Sovol3d/SV06-PLUS/SV06 PLUS-Screen/DWIN_SET/065_C_PrintHeating.jpg

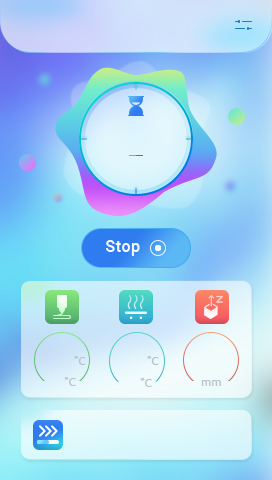
SV06 PLUS-Screen/DWIN_SET/065_C_PrintHeating.jpg
