Sovol3d/SV06-PLUS/SV06 PLUS-Screen/DWIN_SET/013_C_PrintConfirm.jpg

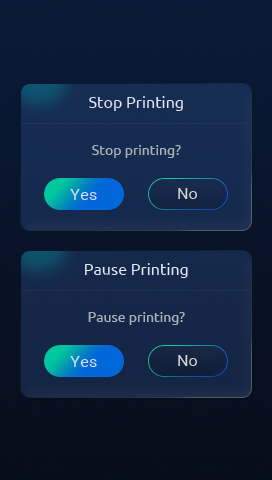
SV06 PLUS-Screen/DWIN_SET/013_C_PrintConfirm.jpg
