Sovol3d/SV06-PLUS/README.md

# Introduction

Sovol SV06 Plus 3d printer is the larger version of Sovol SV06 but with some new upgrades. Its large 300x300x340mm build volume meets all your 3D printing needs, also it comes with some new upgrade. It comes with a new sovol self-developed high flow all metal hotend, the bigger melt zone and traffic make it capable to print at 150mm/s as standard printing speed. Added touch screen, it looks more fashion and technical. Besides, it  has the 450 watt PSU, filament sensor, spinnable spool holder. Welcome to check more on sovol3d.com.
# Related tutorials 

- User Manual. [Click here](https://drive.google.com/file/d/1bJmc2MeOSmn5svG3CuQQvvp3vNMjcOrR/view)
- Sovol Tech Support Youtube Channel: https://www.youtube.com/@sovoltechsupport/videos 
# Learn more

on Sovol Official Website: https://sovol3d.com/products/sovol-sv06-plus

# Source code

This is the official source code for Sovol SV06 PLUS. The damage caused by modifying firmware also using the third party firmware will lose the 1 year warranty. If you need support, it’s recommended to reflash the stock firmware before contacting sovol.

Sovol doesn’t provide tech help for help users to modify source code, but if you need us to add more functions, you are welcome to send us your suggestions via Facebook Messenger or email 
info@sovol3d.com

# Join Sovol Community

- Sovol Facebook page: https://www.facebook.com/sovol3d/
- Sovol Youtube Channel: https://www.youtube.com/c/Sovol/videos
- Sovol Offcial User Group: https://www.facebook.com/groups/sovol3d
- Sovol Forum website: https://forum.sovol3d.com/
- Sovol SV06 PLUS & SV06 Official User Group: https://www.facebook.com/groups/sovolsv06usergroup
