Sovol3d/SV06-PLUS/SV06 PLUS Mechanical PDF/JXHSV06P-08001-g adapter board to motherboard cable.pdf

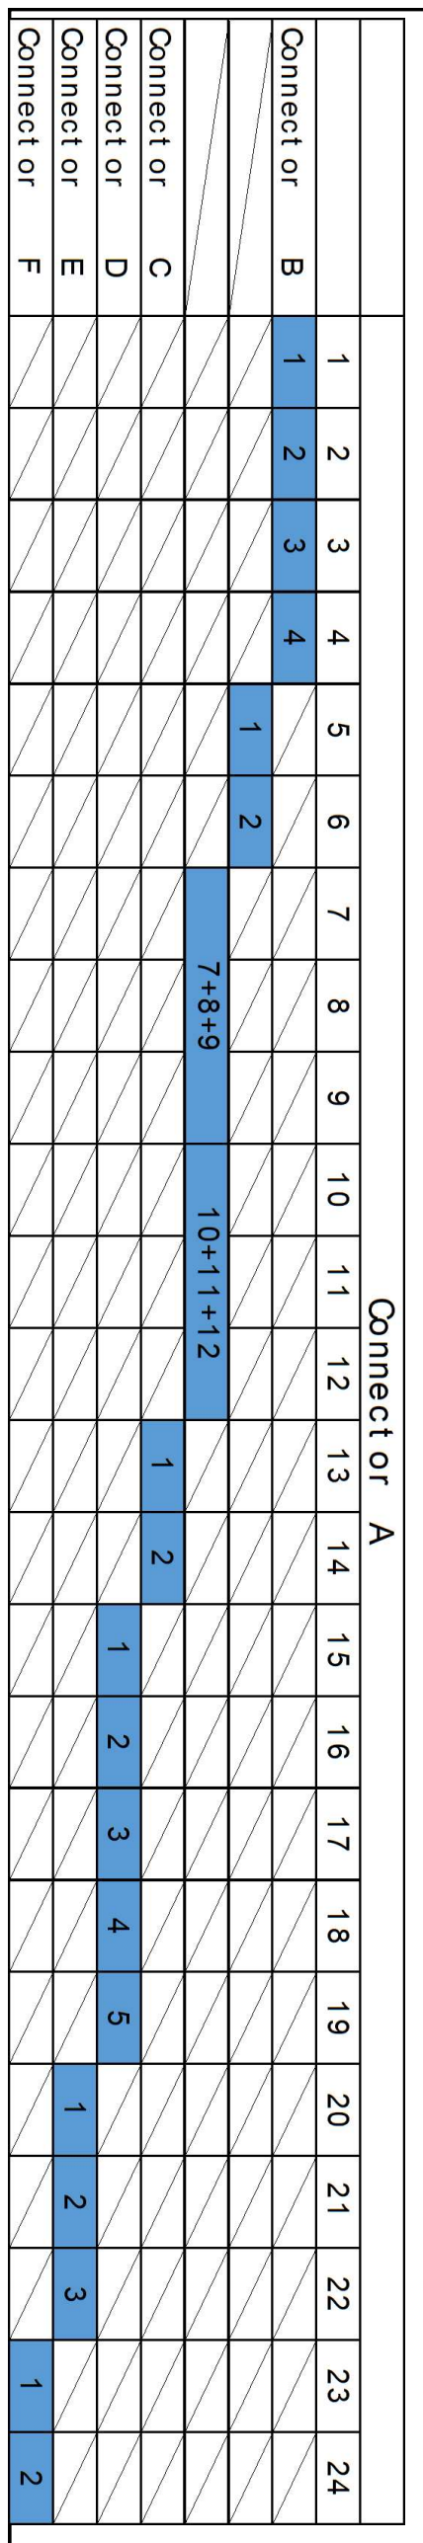
[picture p3: figure]

242 23 1 cable 26AWGCopperspacing1.0mmblack UL 1007 FC 24pin 2.0spacing black Connector A WWrapped with black acetate tape idth 30mm 100mm±10 length Tail tear Connector IIDEseven 640±10 740±10 41 woven mesh Wrapped in black 14 XH 2.54*4P Connector B Wire No. Tube Marking"E 1 3 XH2.54-3Pterminal Wire No. Tube Marking"DET Connector E 3 1 Wire No. Tube Marking"FAN-" terminals E0508 Crimp black tubular pre-insulated E0508 Crimp Red Tube Pre-Insulated terminal Wire No. Tube Marking"FAN+” Tube Marking"K-FAN" Connector CWire No. XH 2.54*5P Connector D 51 XH 2.54*2P Connector C 12 51 terminalsE0508 3Wire merging + crimping red tubular pre-insulated Tube+" Line No. Tube Mark "Heating pre-insulated terminalsE0508 3Wire merging + crimping black tubular Wire No. Tube Marking "Heating Tube-" 21 Wire No. Tube Marking"TH" XH 2.54*2P Connector F 21 21 Wiring diagram JXHSV06P-08001-g JXHSV06P Adapter-motherboard connection line Liu Ye Wrapped in black acetate (placed near the "E" end) Length 180mm width 10mm thickness 0.4mm Cable support plate tape width 30mm(This acetate tape will be Cable support plate fixed) WWrapped with black acetate tape udth 30mm 15 15 180

## 10 Version A0 Material Code

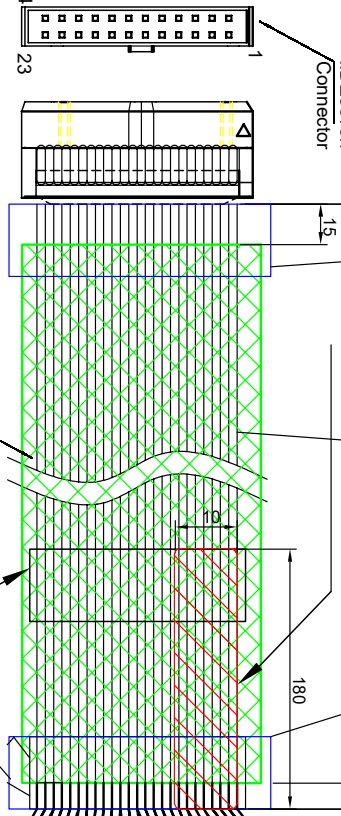
[picture p4: figure]
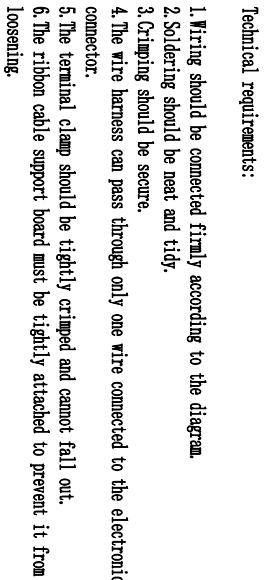
[picture p5: figure]
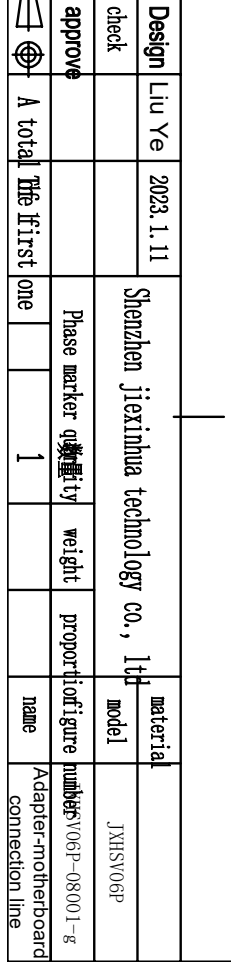
[picture p6: figure]
