Sovol3d/SV06-PLUS/SV06 PLUS Mechanical PDF/JXHSV06P-08002-g X axis cable.pdf

# serial describe model quantity 1

2

3
4

5 4PCS et mr ni al 6 X axis cable wire 1PCS case plastic terminal ptube number Line lastic case 1007 24AWG 4Pparallel black mark：X xxmm 4PCS 1PCS PH2.0-T PH2.0-6Y white XH2.54-T XH2.54-4Y 4x30 Ref 12 34 5 Tube"X Digital Tube"X" Digital jumpers 2,3 540±5mm 61 41 Aend Bend Aend Bend 1 32 634 1 wire sheet 4 XH2.54-4Yterminal Liu Ye 2022/12/9 JXHSV06P JXHSV06P-08002-g Version A0 Material coding

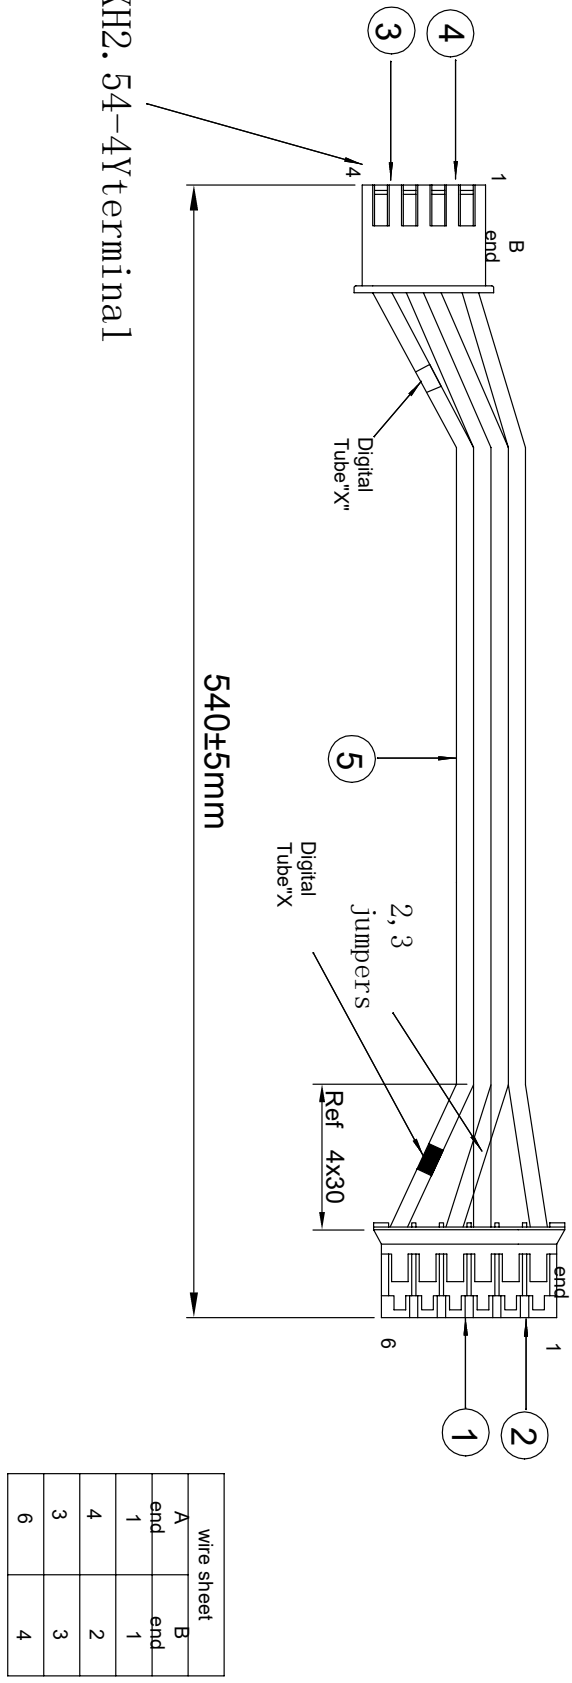
[picture p7: figure]
