Sovol3d/SV06-PLUS/SV06 PLUS Mechanical PDF/JXHSV06P-08017-g YZ axis cable（1）.pdf

# serial description model quantity 1

2

3
4

5 4PCS et mr ni all 6 JXHSV06P wire 1PCS nLine umber ettubemr ni all case plastic p al st ci cover 1007 24AWG 4P parallel black marker：Y xxmm 4PCS 1PCS PH2.0-T PH2.0-6Y white XH2.54-T XH2.54-4Y 4x30 Ref 12 34 5 2,3jumpers 480±5mm 61 41 A end B end A end B end 1 32 634 1 wiring table 4 Terminal XH2.54-4Y nixie tube mark "Y This end sets the mark "Y nixie tube sets the This end terminal PH2.0-6Y JXHSV06P-08017-g version A0 number Material
