Sovol3d/SV06-PLUS/SV06 PLUS Mechanical PDF/JXHSV06P-08017-g YZ axis cable（2）.pdf

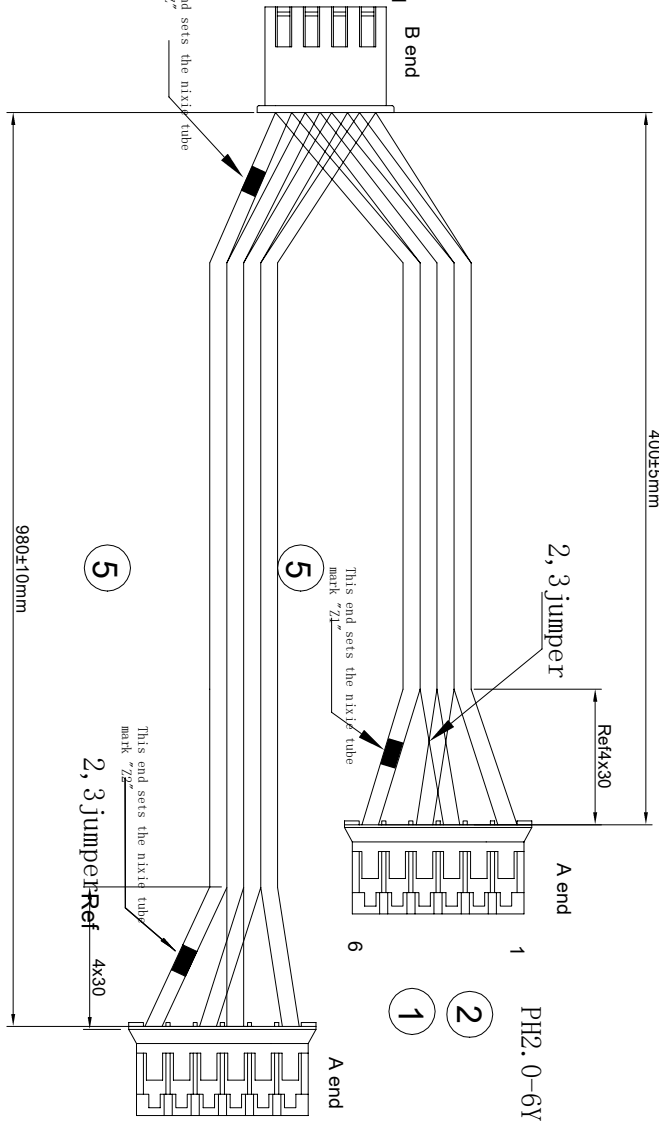
[picture p8: figure]
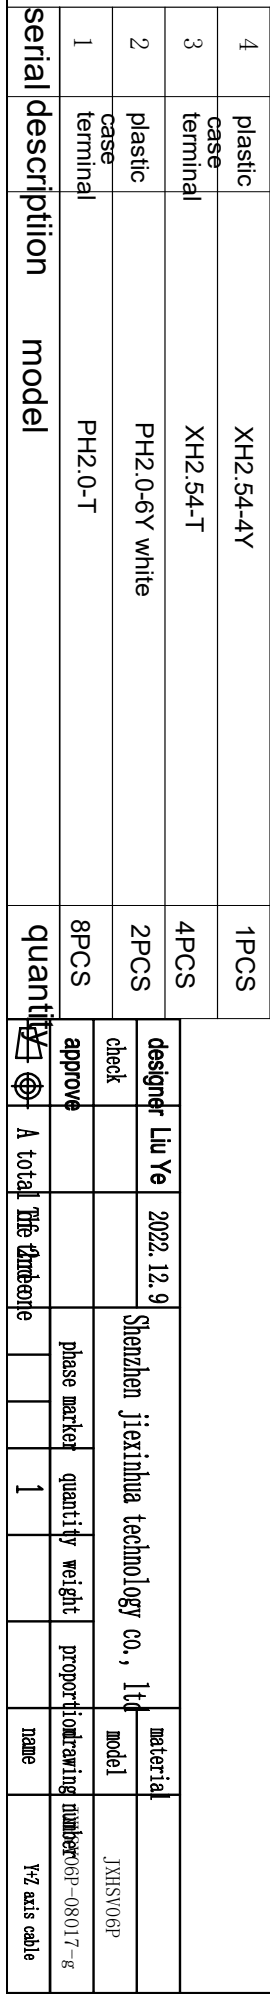
[picture p9: figure]
serial descriptiion model quantity 1

5 8PCS et mr ni al 6 JXHSV06P wire 2PCS ettube number wire mr ni al case plastic p al st ci case 1007 24AWG 4Pparaller black marker：Z，Z1，Z2 xxmm 4PCS 1PCS PH2.0-T PH2.0-6Y white XH2.54-T XH2.54-4Y 4x30 Ref 12 34 5 2,3jumper 61 41 A end B end A end B end 1 32 634 1 wiring table 4 terminal

XH2.54-4Y 5 61 2,3jumper Ref4x30 A end 980±10mm 400±5mm mark "Z" This end sets the nixie tube mark "Z1" This end sets the nixie tube PH2.0-6Y terminal PH2.0-6Y terminal mark "Z2" This end sets the nixie tube 12 JXHSV06P-08017-g version A0 number material
