Sovol3d/SV06-PLUS/SV06 PLUS Mechanical PDF/JXHSV06P-08017-g YZ axis cable（3）.pdf

2 B endB end A end Aend A end Yaxis cable Z axis cable black acetate glue 1 black acetate tape serial description model quantity 123456 JXHSV06P 1PCS Combine Ymotor wire,ZTwo-in-one motor cable wire wire 1PCS Y axis wire z ax si wire JXHSV06P-08017-g Version A0 material code 15±5mm 15±5mm 15±5mm 15±5mm 90±10mm

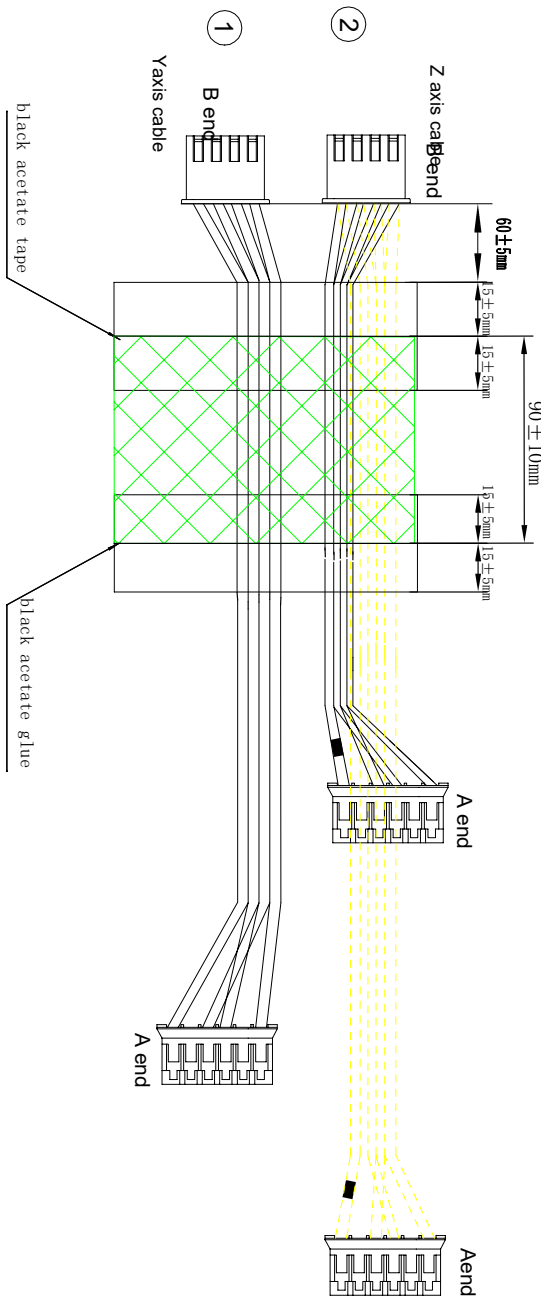
[picture p10: figure]
