Sovol3d/SV06-PLUS/SV06 PLUS Mechanical PDF/JXHSV06P-08022-g power cable( connect to mainboard).pdf

# serial description model quantity 1

2

3

### 4 plug MT60 M- (ma el ) tube digital mark：POWER 1 2 Marking"POWER

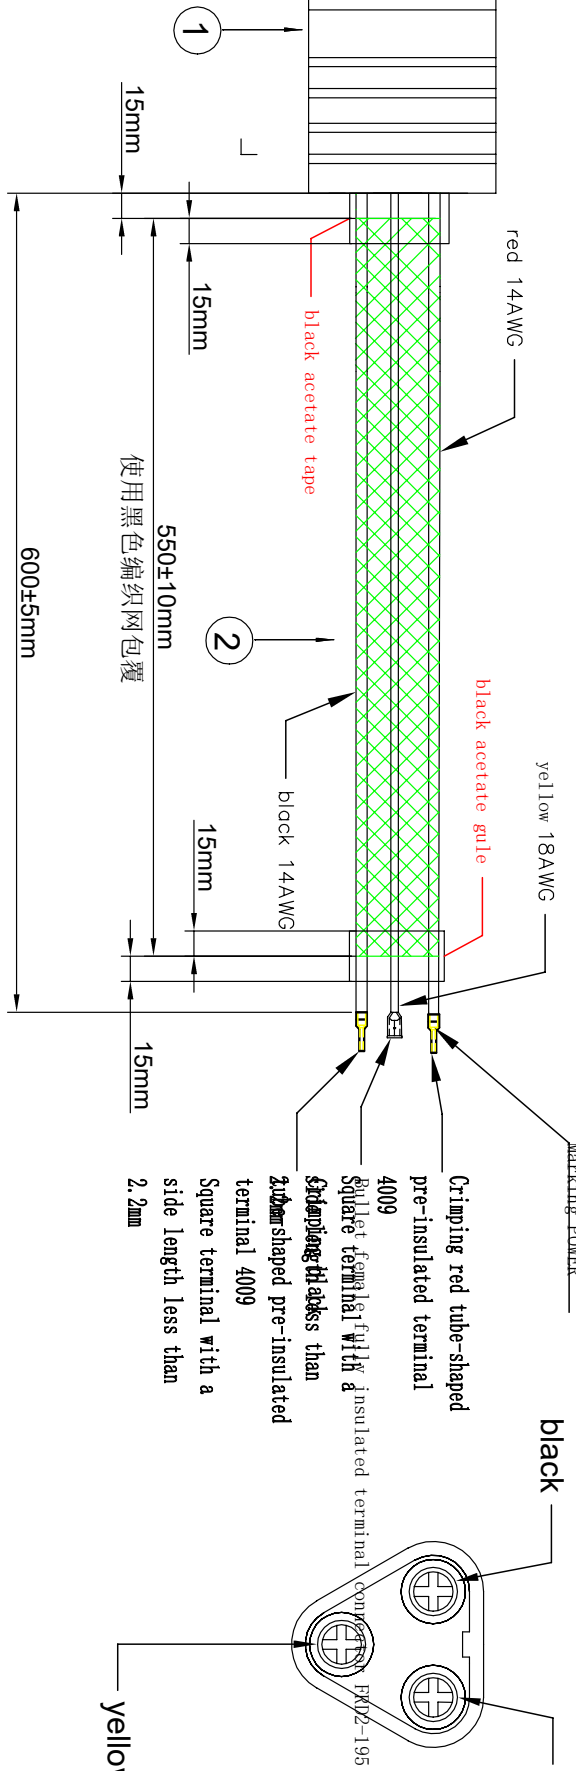
[picture p11: figure]
yellow

## Wire No. Tube

使用黑色编织网包覆 wire 14AWG red and b al ck wire Bullet female fully insulated terminal connector FRD2-195 blue

black acetate tape 550±10mm 15mm 600±5mm black acetate gule version A0 material code wire 18AWGyel ol w wire REV. DATE REVISION ORIGINOR SIGN ISSUED 2023.3.17 18AWG connect to the ground wire to Enda Wang 15mm 15mm 15mm yellow black red
