Sovol3d/SV06-PLUS/SV06 PLUS Mechanical PDF/JXHSV06P-08023-g filament runout sensor(connect to detect device).pdf

approve check design a total of one first The name 比例 weight quantity phase marker drawing number model material 1 co., ltd Shenzhen jiexinhua technology C2502-H03 black terminal XH2.54-3P 700±10mm filament runout sensor (connected the detection device) number serial description model quantity 123456 wire xxmm JXHSV06P-08023-g JXHSV06P 1007 24AWG black three black lines version A0 material code Liu Ye

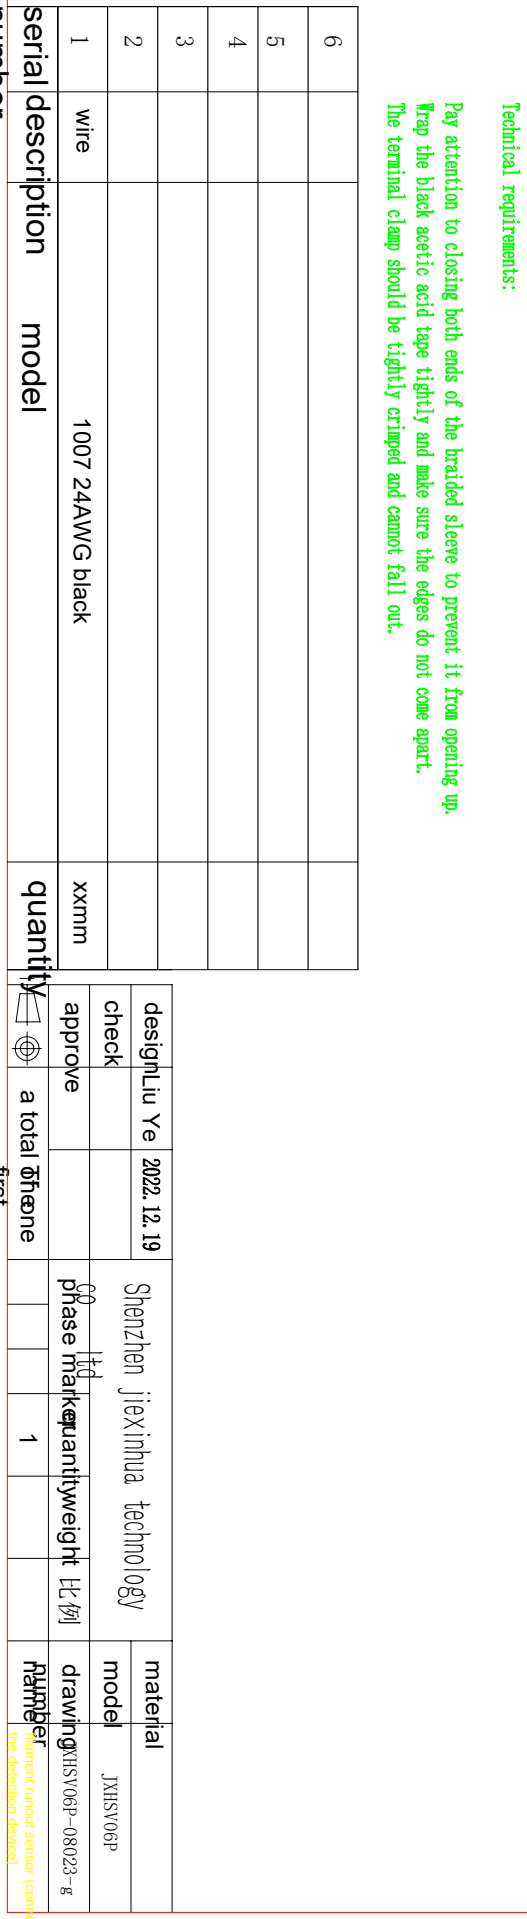
[picture p12: figure]
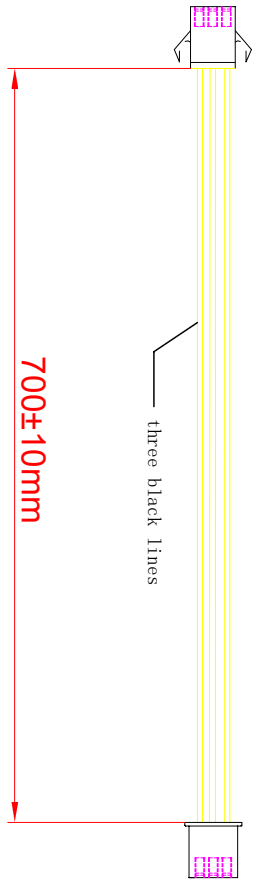
[picture p13: figure]
