Sovol3d/SV06-PLUS/SV06 PLUS Mechanical PDF/JXHSV06P-08024-g filament runout sensor（connect to mainboard）.pdf

approve check design a total o fone first The name proportion weight quantity phase marker drawing number model material 1 co., ltd Shenzhen jiexinhua technology filament runout sensor (connected the motherboard) Liu Ye C2501-H03 buckle XH2.54-3Pterminal 220±5mm number serial description model quantity 123456 wire This end sets the nixie tube mark "DET JXHSV06P JXHSV06P-08024-g 1007 24AWG black 3 black wire aligned version A0 material code

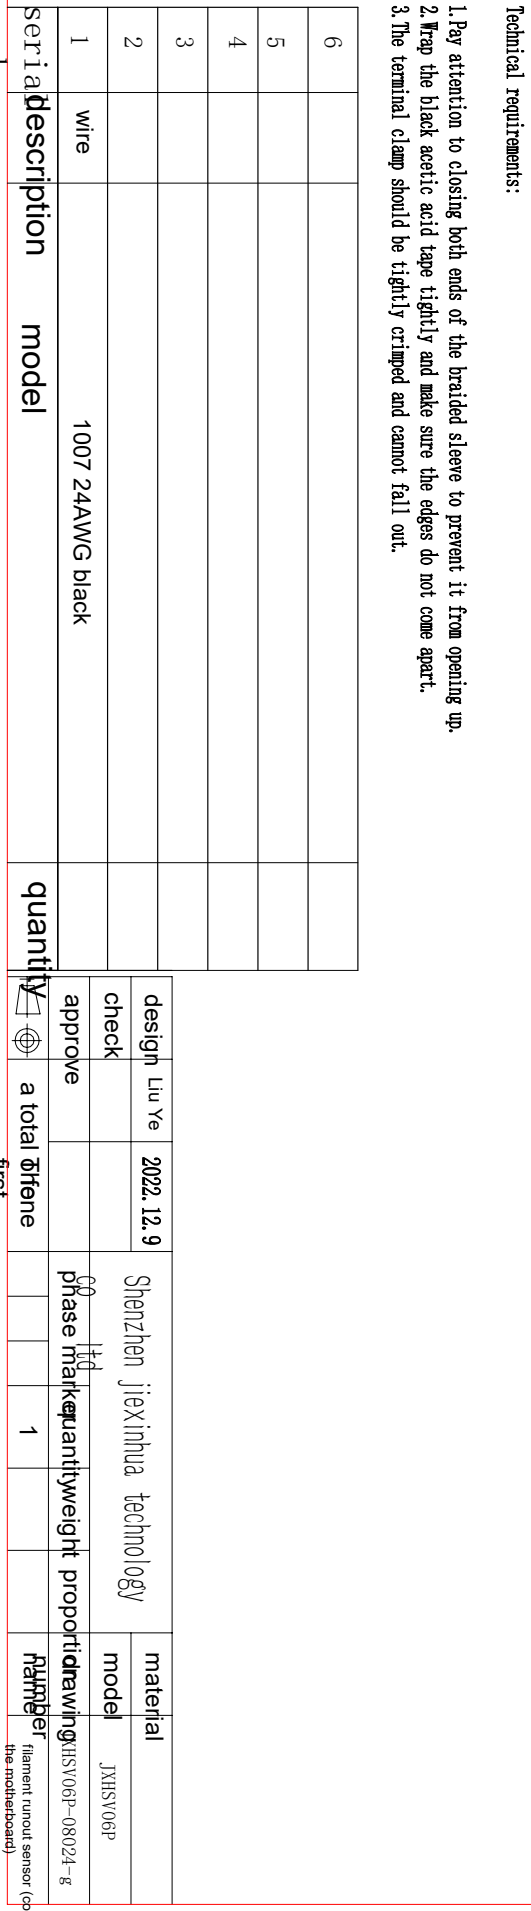
[picture p14: figure]
