Sovol3d/SV06-PLUS/SV06 PLUS-Screen/32_main/000_starting.jpg

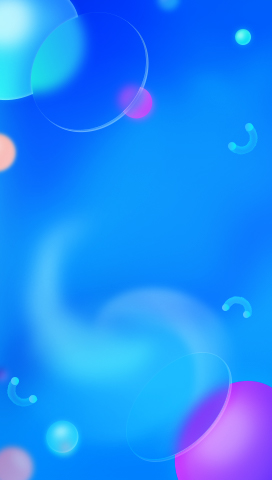
SV06 PLUS-Screen/32_main/000_starting.jpg
