Sovol3d/SV06-PLUS/SV06 PLUS-Screen/32_main/007_C_FilamentChange.jpg

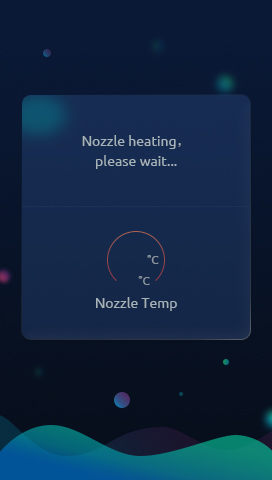
SV06 PLUS-Screen/32_main/007_C_FilamentChange.jpg
