Sovol3d/SV06-PLUS/SV06 PLUS-Screen/32_main/015_C_TempControl.jpg

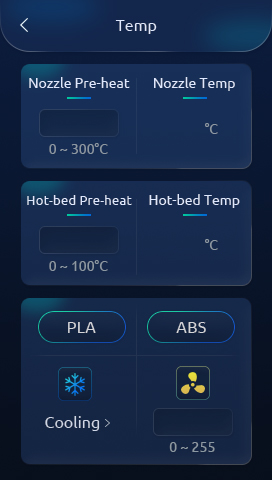
SV06 PLUS-Screen/32_main/015_C_TempControl.jpg
