Sovol3d/SV06-PLUS/SV06 PLUS-Screen/32_main/019_C_ControlConfirm.jpg

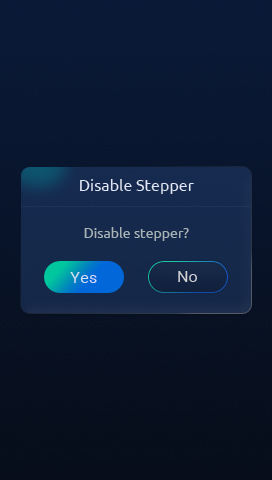
SV06 PLUS-Screen/32_main/019_C_ControlConfirm.jpg
