Sovol3d/SV06-PLUS/SV06 PLUS-Screen/32_main/022_C_BedLeveling.jpg

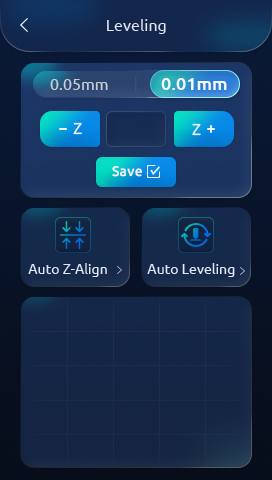
SV06 PLUS-Screen/32_main/022_C_BedLeveling.jpg
