Sovol3d/SV06-PLUS/SV06 PLUS-Screen/32_main/023_C_ChangeFilement.jpg

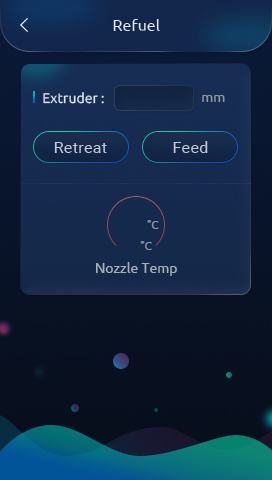
SV06 PLUS-Screen/32_main/023_C_ChangeFilement.jpg
