Sovol3d/SV06-PLUS/SV06 PLUS-Screen/32_main/027_C_CancelChange.jpg

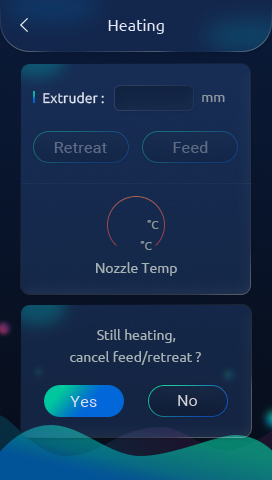
SV06 PLUS-Screen/32_main/027_C_CancelChange.jpg
