Sovol3d/SV06-PLUS/SV06 PLUS-Screen/32_main/031_C_01mmMove.jpg

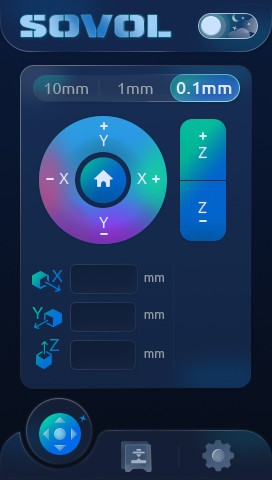
SV06 PLUS-Screen/32_main/031_C_01mmMove.jpg
