Sovol3d/SV06-PLUS/SV06 PLUS-Screen/32_main/032_C_Autohome.jpg

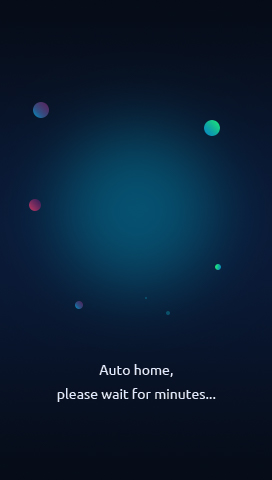
SV06 PLUS-Screen/32_main/032_C_Autohome.jpg
