Sovol3d/SV06-PLUS/SV06 PLUS-Screen/32_main/042_C_CoolDown.jpg

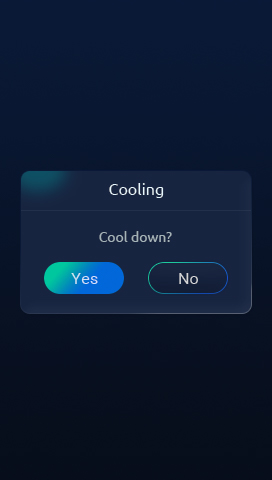
SV06 PLUS-Screen/32_main/042_C_CoolDown.jpg
