Sovol3d/SV06-PLUS/SV06 PLUS-Screen/32_main/048_C_InitConfirm.jpg

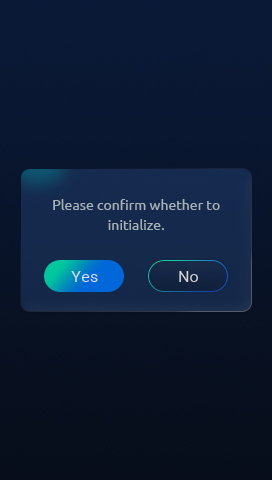
SV06 PLUS-Screen/32_main/048_C_InitConfirm.jpg
