Sovol3d/SV06-PLUS/SV06 PLUS-Screen/32_main/051_KeyboardPush.jpg

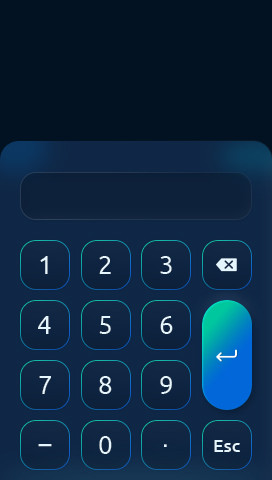
SV06 PLUS-Screen/32_main/051_KeyboardPush.jpg
