Sovol3d/SV06-PLUS/SV06 PLUS-Screen/32_main/053_heatingfailed.jpg

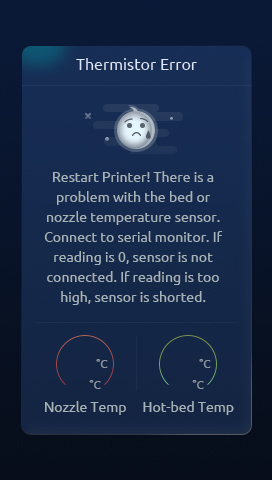
SV06 PLUS-Screen/32_main/053_heatingfailed.jpg
