Sovol3d/SV06-PLUS/SV06 PLUS-Screen/32_main/063_C_FilamentResume.jpg

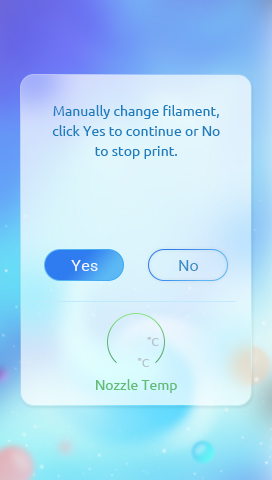
SV06 PLUS-Screen/32_main/063_C_FilamentResume.jpg
