Sovol3d/SV06-PLUS/SV06 PLUS-Screen/32_main/069_C_Ajustment.jpg

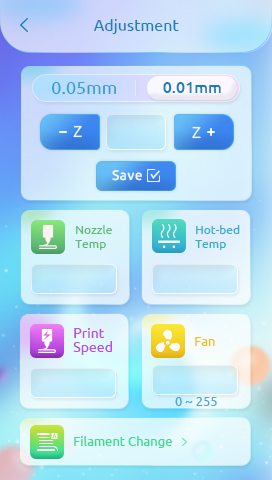
SV06 PLUS-Screen/32_main/069_C_Ajustment.jpg
