Sovol3d/SV06-PLUS/SV06 PLUS-Screen/32_main/075_C_NoFilament.jpg

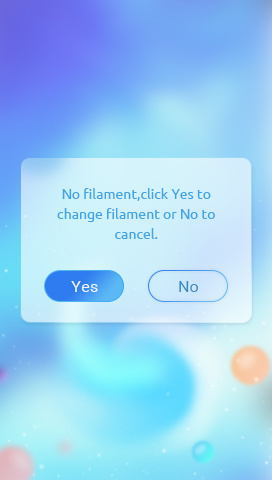
SV06 PLUS-Screen/32_main/075_C_NoFilament.jpg
