Sovol3d/SV06-PLUS/SV06 PLUS-Screen/32_main/076_C_Tool.jpg

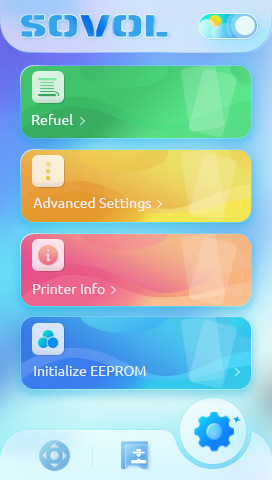
SV06 PLUS-Screen/32_main/076_C_Tool.jpg
