Sovol3d/SV06-PLUS/SV06 PLUS-Screen/32_main/079_C_Warn1.jpg

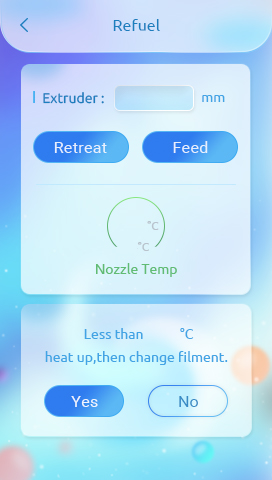
SV06 PLUS-Screen/32_main/079_C_Warn1.jpg
