Sovol3d/SV06-PLUS/SV06 PLUS-Screen/32_main/080_C_Vetocity.jpg

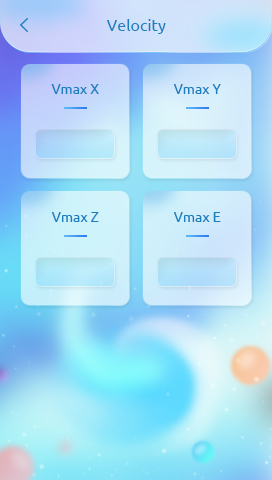
SV06 PLUS-Screen/32_main/080_C_Vetocity.jpg
