Sovol3d/SV06-PLUS/SV06 PLUS-Screen/32_main/085_C_1mmMove.jpg

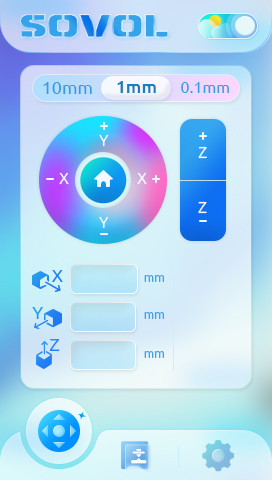
SV06 PLUS-Screen/32_main/085_C_1mmMove.jpg
