Sovol3d/SV06-PLUS/SV06 PLUS-Screen/32_main/089_C_Acceleration.jpg

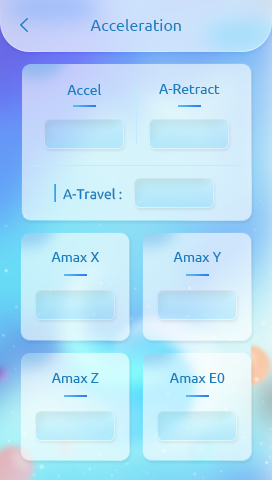
SV06 PLUS-Screen/32_main/089_C_Acceleration.jpg
