Sovol3d/SV06-PLUS/SV06 PLUS-Screen/32_main/104_AdvancedSetting.jpg

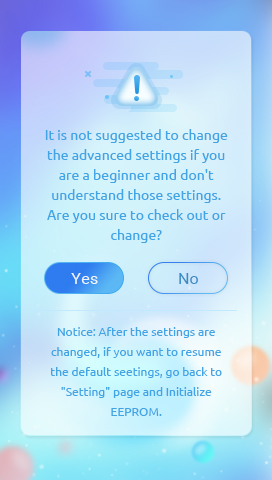
SV06 PLUS-Screen/32_main/104_AdvancedSetting.jpg
