Sovol3d/SV06-PLUS/SV06 PLUS-Screen/32_main/105_Keyboard.jpg

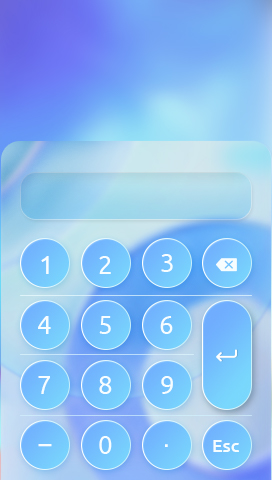
SV06 PLUS-Screen/32_main/105_Keyboard.jpg
