Sovol3d/SV06-PLUS/SV06 PLUS-Screen/32_main/108_heatingfailed.jpg

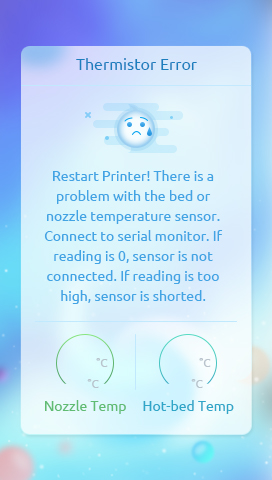
SV06 PLUS-Screen/32_main/108_heatingfailed.jpg
