Sovol3d/SV06-PLUS/SV06 PLUS-Screen/32_main/113_TMC Drivers.jpg

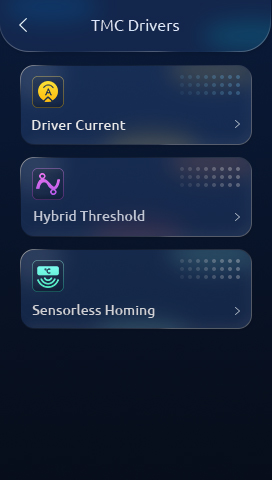
SV06 PLUS-Screen/32_main/113_TMC Drivers.jpg
