Sovol3d/SV06-PLUS/SV06 PLUS-Screen/32_main/114_Driver Current.jpg

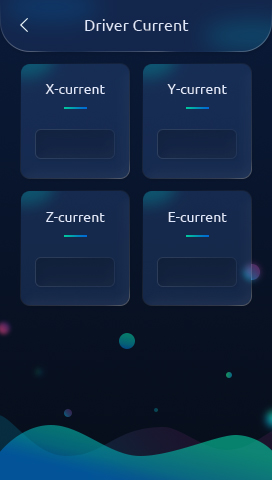
SV06 PLUS-Screen/32_main/114_Driver Current.jpg
