Sovol3d/SV06-PLUS/SV06 PLUS-Screen/32_main/116_Sensorless Homing.jpg

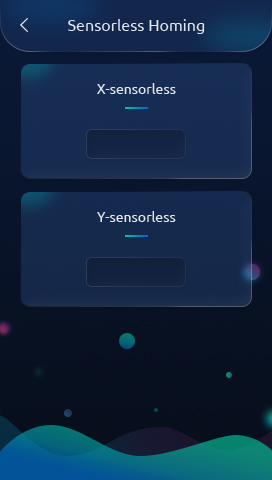
SV06 PLUS-Screen/32_main/116_Sensorless Homing.jpg
