Sovol3d/SV06-PLUS/SV06 PLUS-Screen/32_main/124_C_Wait.jpg

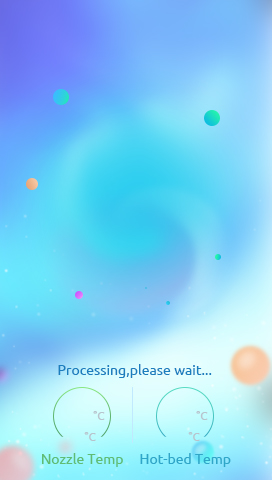
SV06 PLUS-Screen/32_main/124_C_Wait.jpg
