Sovol3d/SV06-PLUS/SV06 PLUS-Screen/47_time/3.jpg

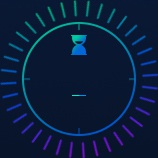
SV06 PLUS-Screen/47_time/3.jpg
