Sovol3d/SV06-PLUS/SV06 PLUS-Screen/49_rleve/3.jpg

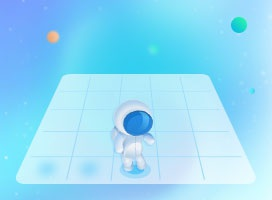
SV06 PLUS-Screen/49_rleve/3.jpg
