Sovol3d/SV06-PLUS/SV06 PLUS-Screen/49_rleve/4.jpg

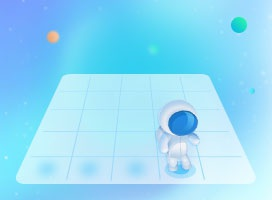
SV06 PLUS-Screen/49_rleve/4.jpg
