Sovol3d/SV06-PLUS/SV06 PLUS-Screen/50_bleve/5.jpg

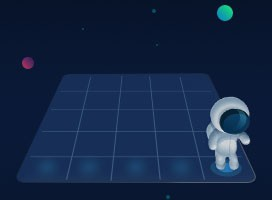
SV06 PLUS-Screen/50_bleve/5.jpg
