Sovol3d/SV06-PLUS/SV06 PLUS-Screen/52_rwait/7.jpg

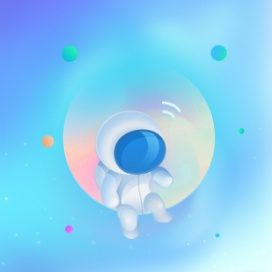
SV06 PLUS-Screen/52_rwait/7.jpg
