Sovol3d/SV06-PLUS/SV06 PLUS-Screen/54_bwait/15.jpg

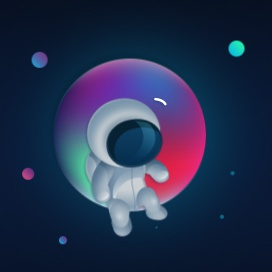
SV06 PLUS-Screen/54_bwait/15.jpg
