Sovol3d/SV06-PLUS/SV06 PLUS-Screen/58_rtime/3.jpg

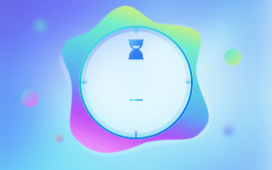
SV06 PLUS-Screen/58_rtime/3.jpg
