Sovol3d/SV06-PLUS/SV06 PLUS-Screen/58_rtime/7.jpg

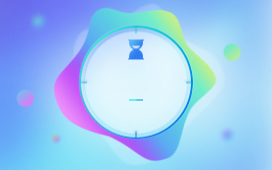
SV06 PLUS-Screen/58_rtime/7.jpg
