Sovol3d/SV06-PLUS/SV06 PLUS-Screen/58_rtime/17.jpg

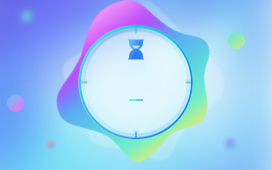
SV06 PLUS-Screen/58_rtime/17.jpg
