Sovol3d/SV06-PLUS/SV06 PLUS-Screen/DWIN_SET/001_C_main.jpg

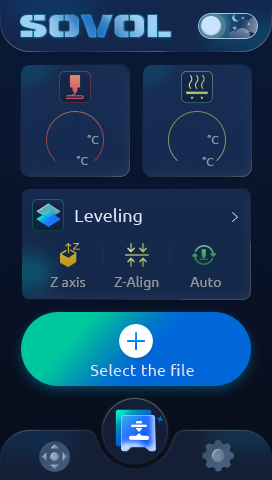
SV06 PLUS-Screen/DWIN_SET/001_C_main.jpg
