Sovol3d/SV06-PLUS/SV06 PLUS-Screen/DWIN_SET/014_C_Ajustment.jpg

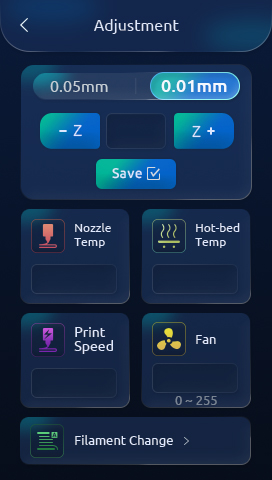
SV06 PLUS-Screen/DWIN_SET/014_C_Ajustment.jpg
