Sovol3d/SV06-PLUS/SV06 PLUS-Screen/DWIN_SET/035_C_Jerk.jpg

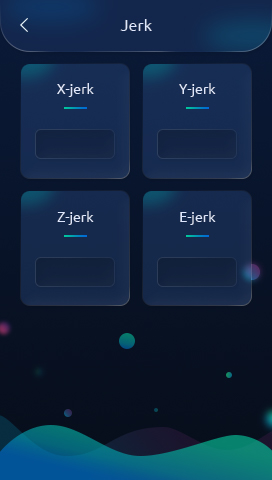
SV06 PLUS-Screen/DWIN_SET/035_C_Jerk.jpg
