Sovol3d/SV06-PLUS/SV06 PLUS-Screen/DWIN_SET/039_C_HeatStop.jpg

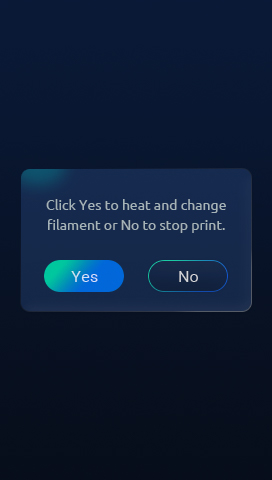
SV06 PLUS-Screen/DWIN_SET/039_C_HeatStop.jpg
