Sovol3d/SV06-PLUS/SV06 PLUS-Screen/DWIN_SET/041_C_TempPID.jpg

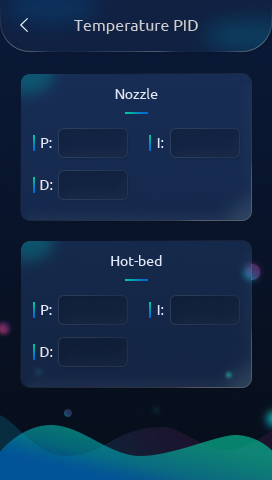
SV06 PLUS-Screen/DWIN_SET/041_C_TempPID.jpg
