Sovol3d/SV06-PLUS/SV06 PLUS-Screen/DWIN_SET/052_thermal_runaway.jpg

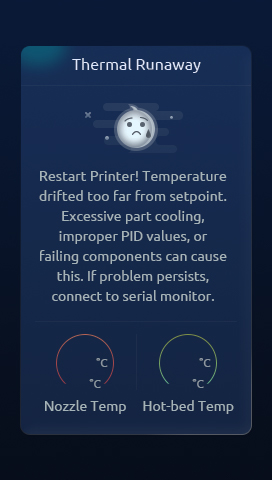
SV06 PLUS-Screen/DWIN_SET/052_thermal_runaway.jpg
