Sovol3d/SV06-PLUS/SV06 PLUS-Screen/DWIN_SET/055_Autohomefailed.jpg

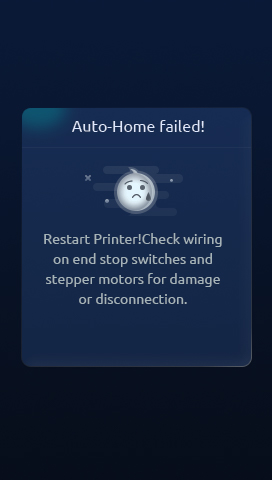
SV06 PLUS-Screen/DWIN_SET/055_Autohomefailed.jpg
