Sovol3d/SV06-PLUS/SV06 PLUS-Screen/DWIN_SET/070_C_TempControl.jpg

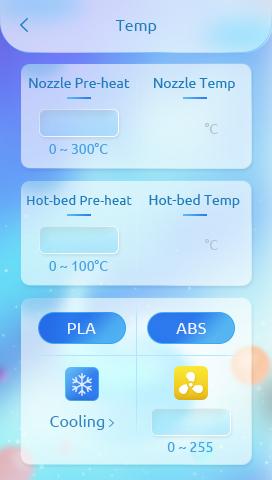
SV06 PLUS-Screen/DWIN_SET/070_C_TempControl.jpg
