Sovol3d/SV06-PLUS/SV06 PLUS-Screen/DWIN_SET/077_C_BedLeveling.jpg

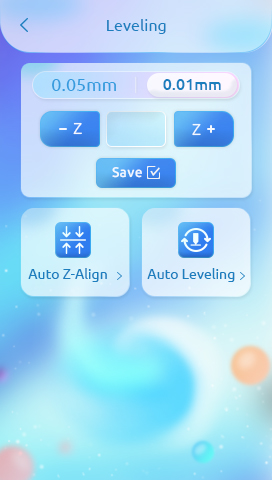
SV06 PLUS-Screen/DWIN_SET/077_C_BedLeveling.jpg
