Sovol3d/SV06-PLUS/SV06 PLUS-Screen/DWIN_SET/087_C_Autohome.jpg

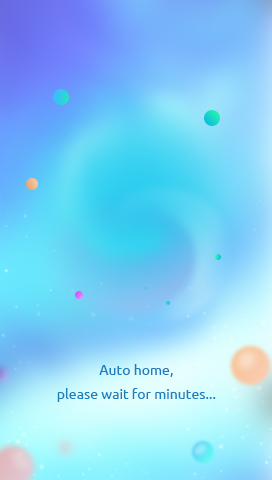
SV06 PLUS-Screen/DWIN_SET/087_C_Autohome.jpg
