Sovol3d/SV06-PLUS/SV06 PLUS-Screen/DWIN_SET/088_C_Information.jpg

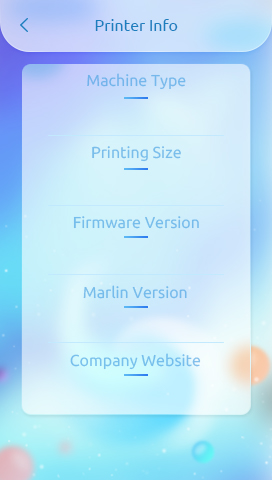
SV06 PLUS-Screen/DWIN_SET/088_C_Information.jpg
