Sovol3d/SV06-PLUS/SV06 PLUS-Screen/DWIN_SET/093_C_Autoleve.jpg

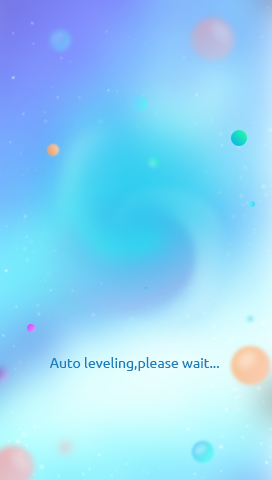
SV06 PLUS-Screen/DWIN_SET/093_C_Autoleve.jpg
