Sovol3d/SV06-PLUS/SV06 PLUS-Screen/DWIN_SET/106_KeyboardPush.jpg

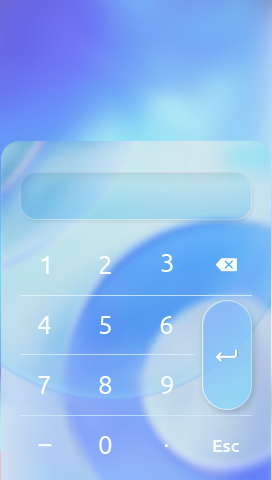
SV06 PLUS-Screen/DWIN_SET/106_KeyboardPush.jpg
