Sovol3d/SV06-PLUS/SV06 PLUS-Screen/DWIN_SET/112_Driver_error.jpg

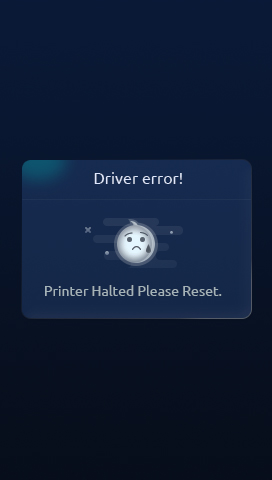
SV06 PLUS-Screen/DWIN_SET/112_Driver_error.jpg
