Sovol3d/SV06-PLUS/SV06 PLUS-Screen/DWIN_SET/119_TMC Drivers.jpg

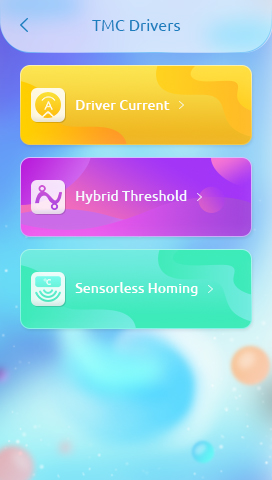
SV06 PLUS-Screen/DWIN_SET/119_TMC Drivers.jpg
