Sovol3d/SV06-PLUS/SV06 PLUS-Screen/DWIN_SET/122_Sensorless Homing.jpg

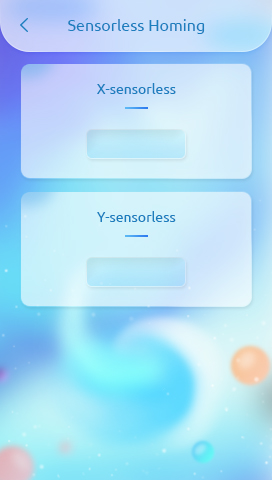
SV06 PLUS-Screen/DWIN_SET/122_Sensorless Homing.jpg
