Sovol3d/SV06-PLUS/SV06 PLUS 3D/STEP/JXHSV06P-01000 base assembly/JXHSV06-01019-d Wire Clip.step

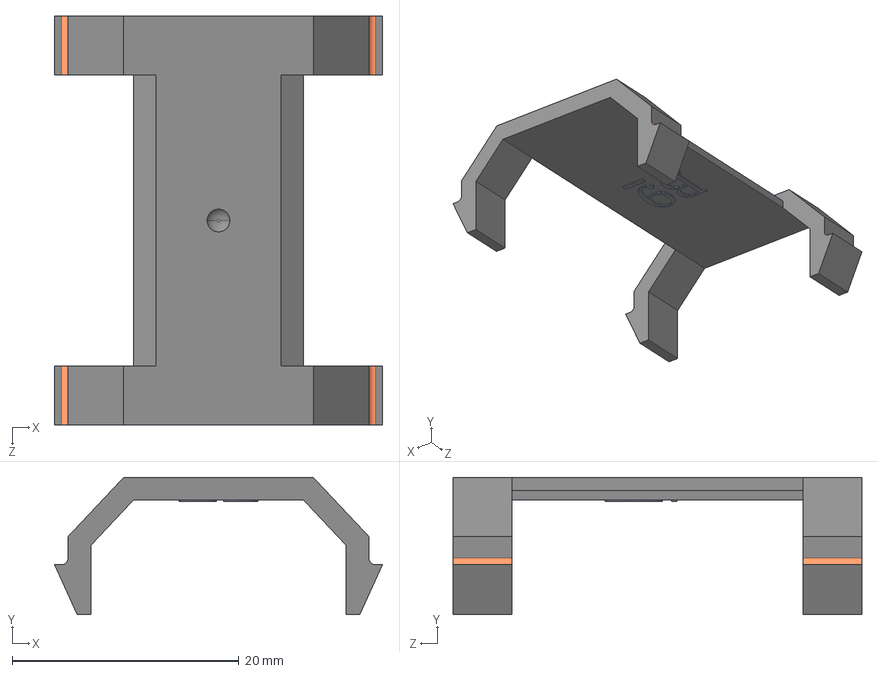
[picture p114: CAD file, 2023-06-09]
SV06 PLUS 3D/STEP/JXHSV06P-01000 base assembly/JXHSV06-01019-d Wire Clip.step
28.9 x 12.1 x 36.0 mm
