Sovol3d/SV06-PLUS/SV06 PLUS 3D/STEP/JXHSV06P-02000 gantry component/JXHSV06P-02007-d Z-axis right guide rod fixing block.step

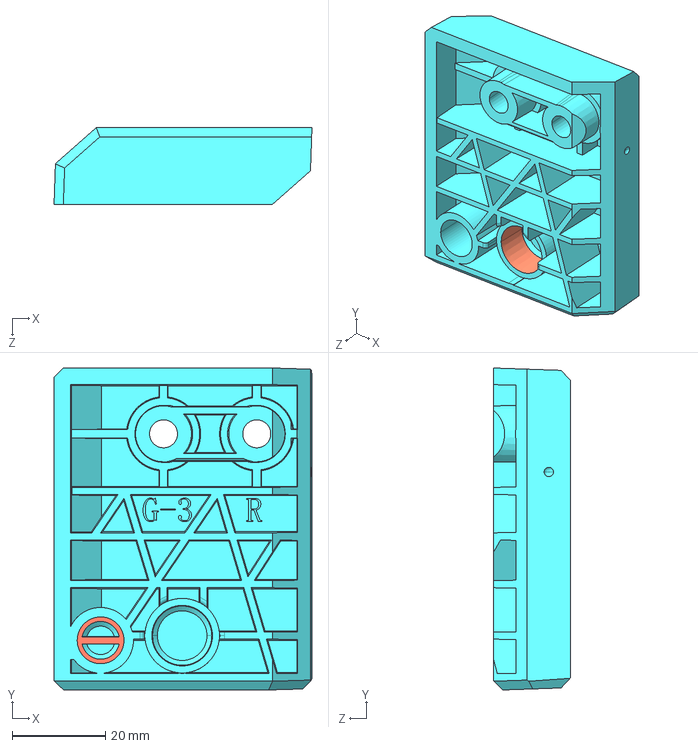
[picture p115: CAD file, 2023-06-09]
SV06 PLUS 3D/STEP/JXHSV06P-02000 gantry component/JXHSV06P-02007-d Z-axis right guide rod fixing block.step
55.3 x 69.1 x 16.5 mm
