Sovol3d/SV06-PLUS/SV06 PLUS 3D/STEP/JXHSV06P-03000 X-axis component/JXHSV06-03005-d X-axis tensioning wheel mounting seat.step

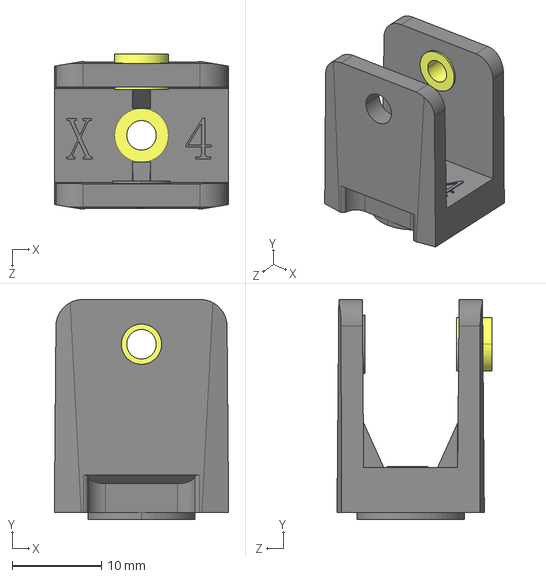
[picture p116: CAD file, 2023-06-09]
SV06 PLUS 3D/STEP/JXHSV06P-03000 X-axis component/JXHSV06-03005-d X-axis tensioning wheel mounting seat.step
19.5 x 24.6 x 17.3 mm
