Sovol3d/SV06-PLUS/SV06 PLUS 3D/STEP/JXHSV06P-04000 motherboard box component/JXHSV06-04003-d motherboard box lower hinge.step

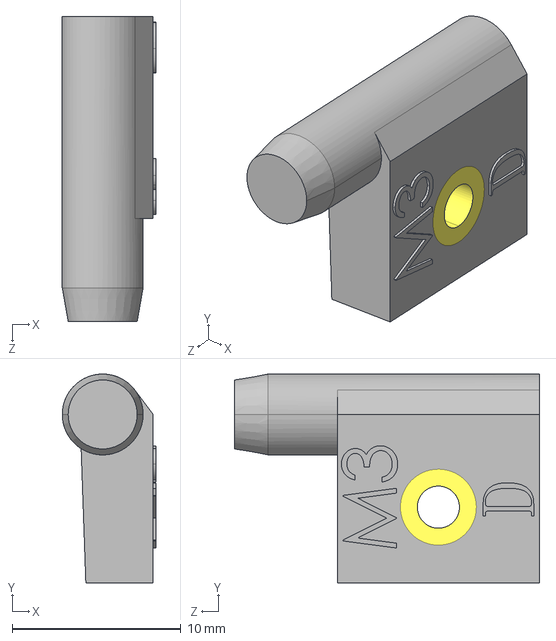
[picture p117: CAD file, 2023-06-09]
SV06 PLUS 3D/STEP/JXHSV06P-04000 motherboard box component/JXHSV06-04003-d motherboard box lower hinge.step
5.55 x 12.4 x 18.1 mm
