Sovol3d/SV06-PLUS/SV06 PLUS 3D/STEP/JXHSV06P-07000 bearing bracket component/JXHSV06P-07005-d center shaft.step

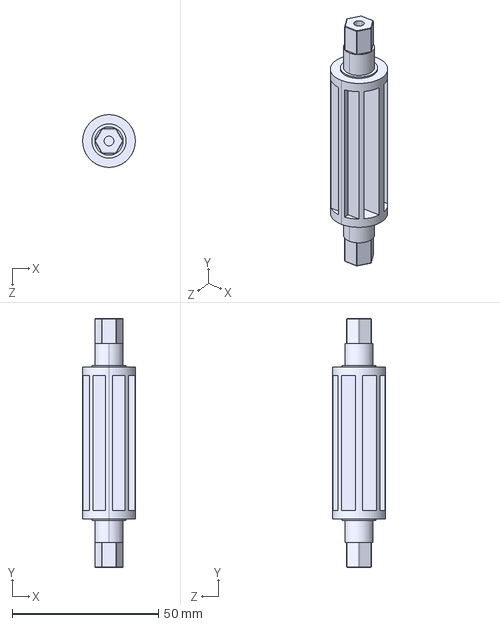
[picture p119: CAD file, 2023-06-09]
SV06 PLUS 3D/STEP/JXHSV06P-07000 bearing bracket component/JXHSV06P-07005-d center shaft.step
18.0 x 85.0 x 18.0 mm
