Sovol3d/SV06-PLUS/SV06 PLUS 3D/STEP/JXHSV06P-08000 Extrusion Assembly/JXHSV06-08003-d Gear Seat.step

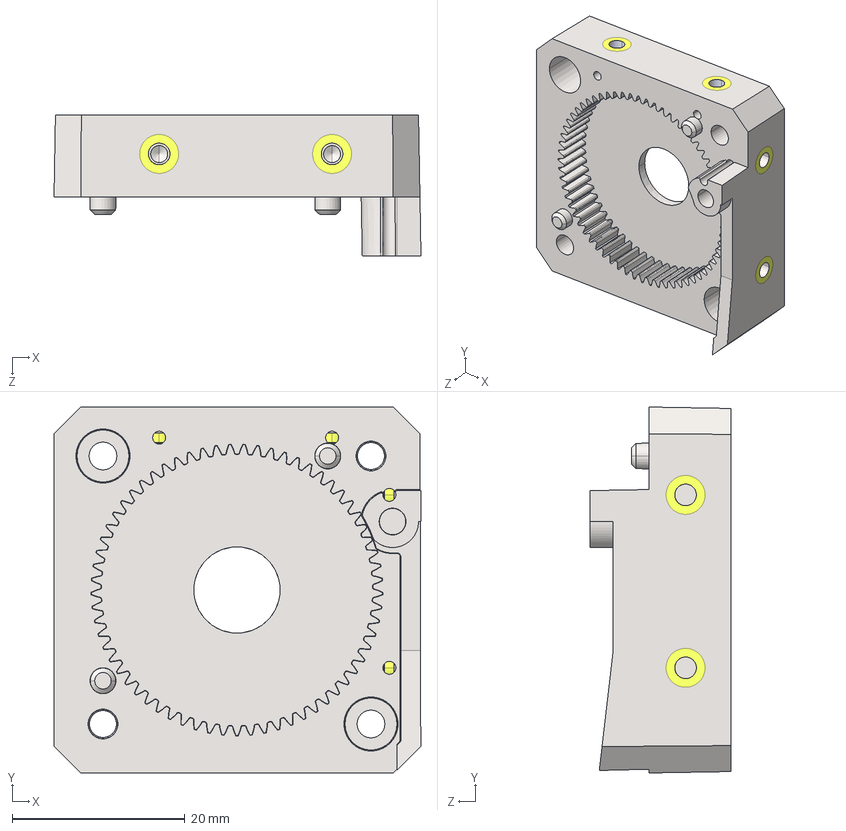
[picture p120: CAD file, 2023-06-09]
SV06 PLUS 3D/STEP/JXHSV06P-08000 Extrusion Assembly/JXHSV06-08003-d Gear Seat.step
42.5 x 42.3 x 16.3 mm
