Sovol3d/SV06-PLUS/SV06 PLUS 3D/STL/JXHSV06P-06000 Touch Screen Component/Touch Screen Component 9-11.STL

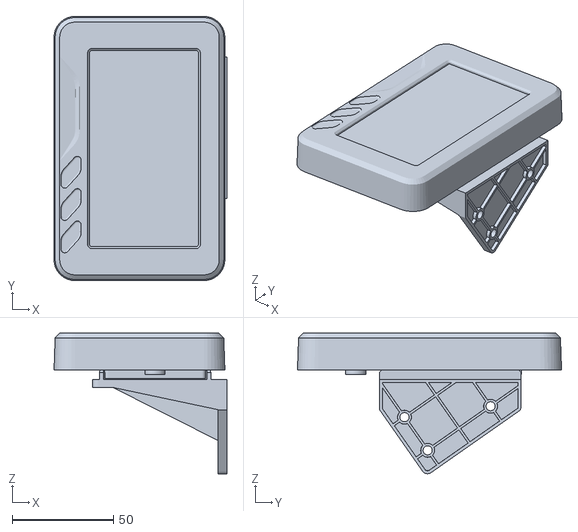
[picture p121: CAD file, 2023-06-10]
SV06 PLUS 3D/STL/JXHSV06P-06000 Touch Screen Component/Touch Screen Component 9-11.STL
85.6 x 130.6 x 69.5
