Sovol3d/SV06-PLUS/SV06 PLUS 3D/STL/JXHSV06P-08000 Extrusion Assembly/JXHSV06-08007-d Cylindrical Gear 27×0.5.STL

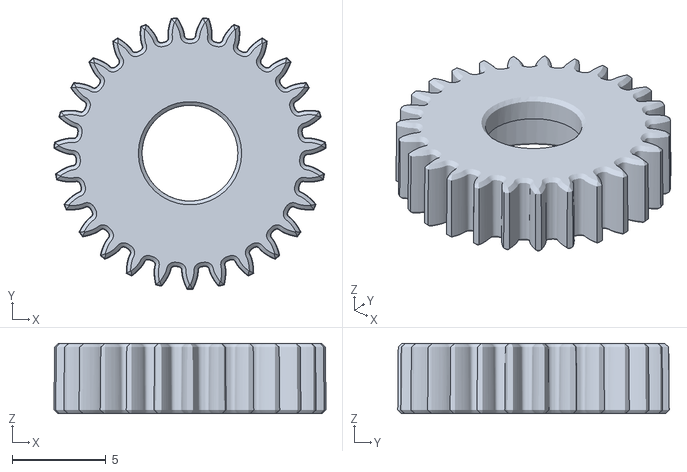
[picture p122: CAD file, 2023-06-10]
SV06 PLUS 3D/STL/JXHSV06P-08000 Extrusion Assembly/JXHSV06-08007-d Cylindrical Gear 27×0.5.STL
14.5 x 14.5 x 3.75
