Sovol3d/SV06-PLUS/SV06 PLUS 3D/STEP/JXHSV06P-01000 base assembly/JXHSV06-01011-d Base Tensioner Mount.step

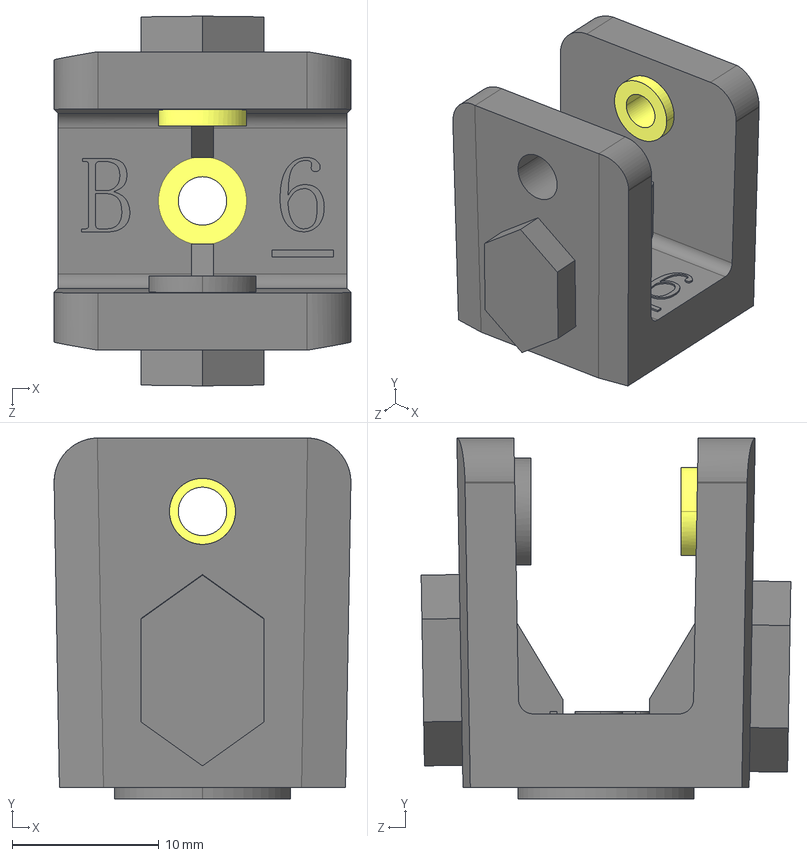
[picture p123: CAD file, 2023-06-09]
SV06 PLUS 3D/STEP/JXHSV06P-01000 base assembly/JXHSV06-01011-d Base Tensioner Mount.step
20.2 x 24.6 x 25.2 mm
