Sovol3d/SV06-PLUS/SV06 PLUS 3D/STEP/JXHSV06P-02000 gantry component/JXHSV06P-02009-d Z-axis right motor mount.step

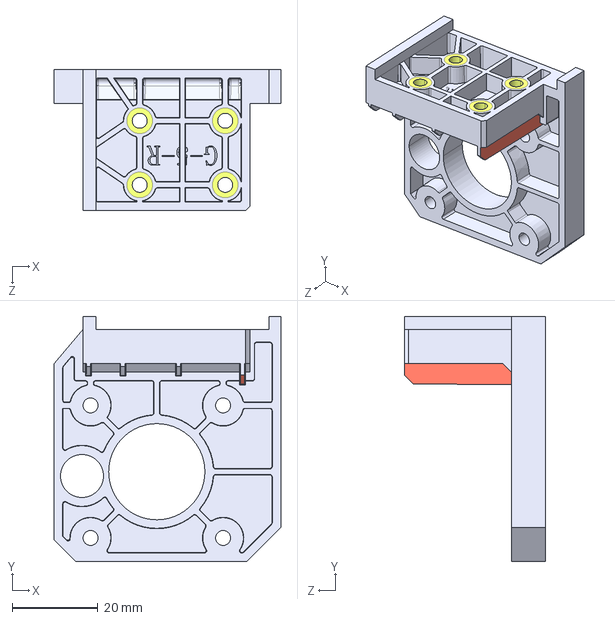
[picture p124: CAD file, 2023-06-09]
SV06 PLUS 3D/STEP/JXHSV06P-02000 gantry component/JXHSV06P-02009-d Z-axis right motor mount.step
53.0 x 57.3 x 33.0 mm
