Sovol3d/SV06-PLUS/SV06 PLUS 3D/STEP/JXHSV06P-03000 X-axis component/JXHSV06-03002-d X-axis motor mounting seat.step

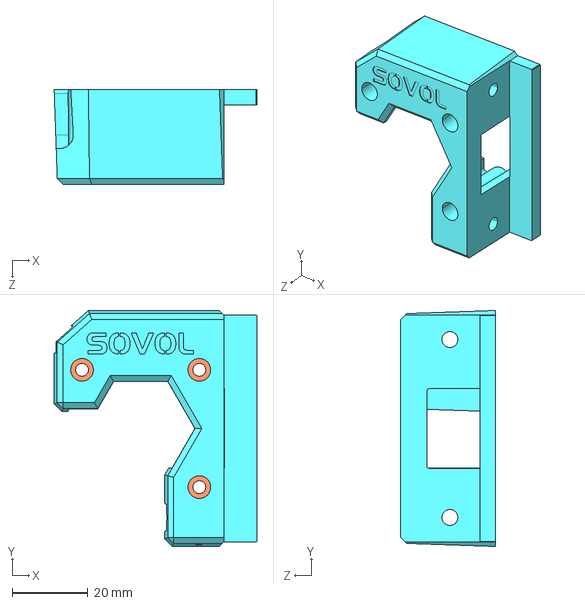
[picture p125: CAD file, 2023-06-09]
SV06 PLUS 3D/STEP/JXHSV06P-03000 X-axis component/JXHSV06-03002-d X-axis motor mounting seat.step
53.6 x 62.4 x 25.0 mm
