Sovol3d/SV06-PLUS/SV06 PLUS 3D/STEP/JXHSV06P-04000 motherboard box component/JXHSV06-04006-d small airplane mold component.step

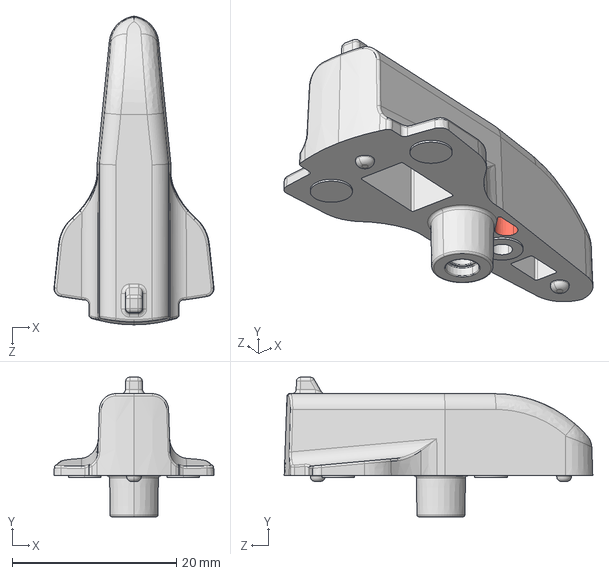
[picture p126: CAD file, 2023-06-09]
SV06 PLUS 3D/STEP/JXHSV06P-04000 motherboard box component/JXHSV06-04006-d small airplane mold component.step
19.5 x 17.0 x 37.6 mm
