Sovol3d/SV06-PLUS/SV06 PLUS 3D/STEP/JXHSV06P-07000 bearing bracket component/JXHSV06P-07004-d feeder fixed end cap.step

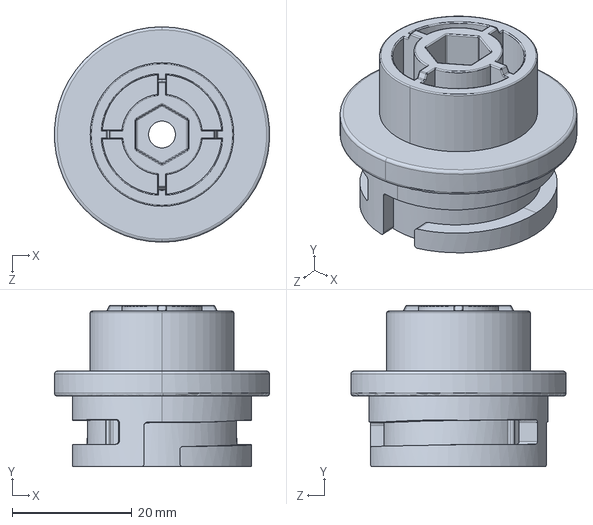
[picture p128: CAD file, 2023-06-09]
SV06 PLUS 3D/STEP/JXHSV06P-07000 bearing bracket component/JXHSV06P-07004-d feeder fixed end cap.step
35.9 x 27.0 x 36.0 mm
