Sovol3d/SV06-PLUS/SV06 PLUS 3D/STEP/JXHSV06P-08000 Extrusion Assembly/JXHSV06P-08013-d Sliding Seat Cover Plate.step

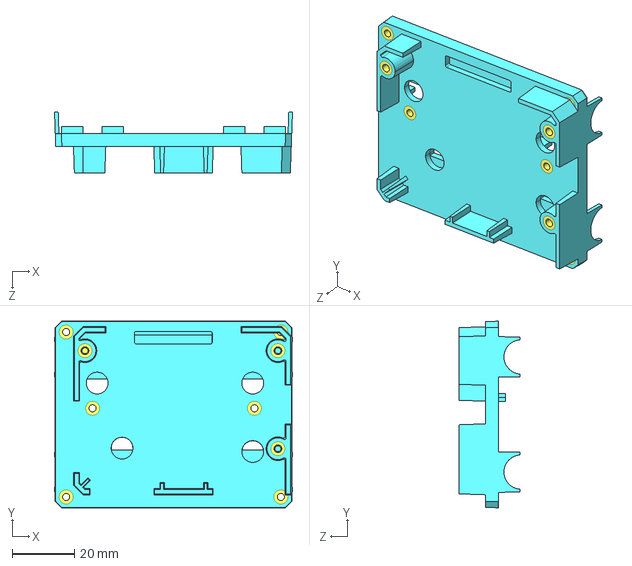
[picture p129: CAD file, 2023-06-09]
SV06 PLUS 3D/STEP/JXHSV06P-08000 Extrusion Assembly/JXHSV06P-08013-d Sliding Seat Cover Plate.step
76.5 x 60.0 x 19.7 mm
