Sovol3d/SV06-PLUS/SV06 PLUS 3D/STEP/JXHSV06P-01000 base assembly/JXHSV06-01017-d Base Tensioner Fixing Piece.step

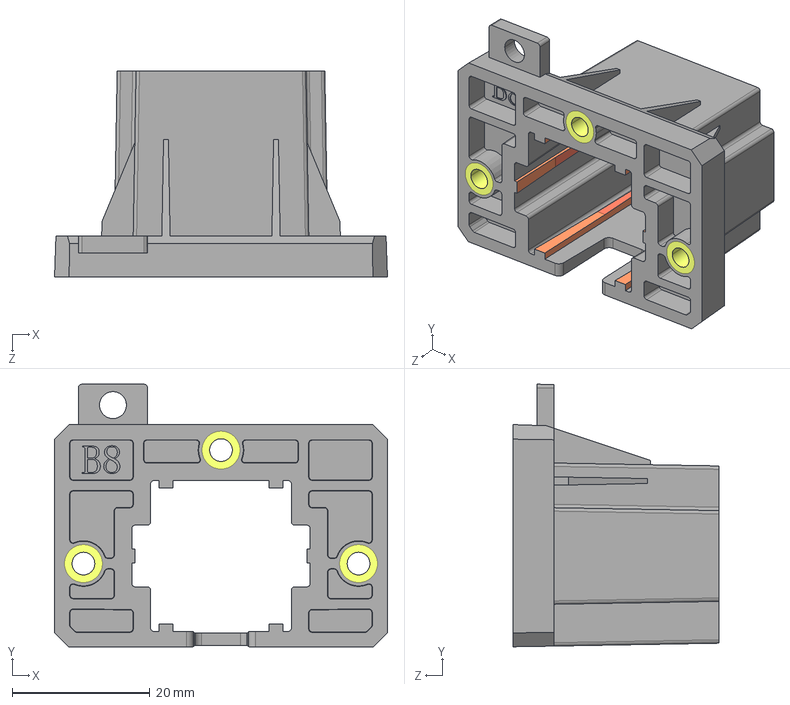
[picture p131: CAD file, 2023-06-09]
SV06 PLUS 3D/STEP/JXHSV06P-01000 base assembly/JXHSV06-01017-d Base Tensioner Fixing Piece.step
48.4 x 38.2 x 30.0 mm
