Sovol3d/SV06-PLUS/SV06 PLUS 3D/STEP/JXHSV06P-02000 gantry component/JXHSV06P-02005-d Gantry crossbeam.step

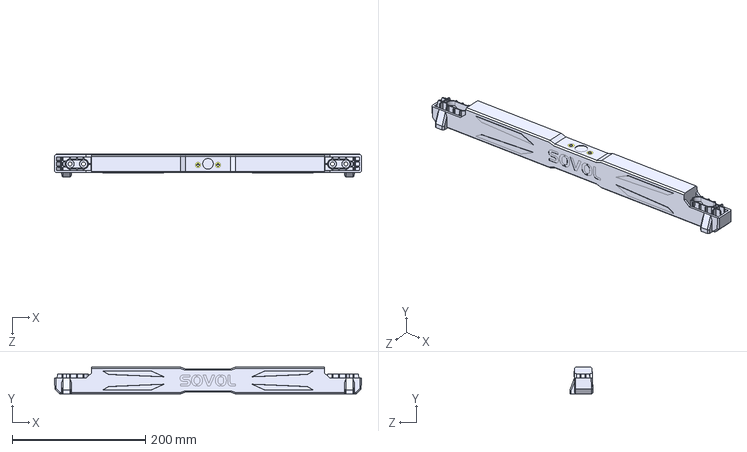
[picture p132: CAD file, 2023-06-09]
SV06 PLUS 3D/STEP/JXHSV06P-02000 gantry component/JXHSV06P-02005-d Gantry crossbeam.step
460.0 x 40.0 x 35.1 mm
