Sovol3d/SV06-PLUS/SV06 PLUS 3D/STEP/JXHSV06P-03000 X-axis component/JXHSV06P-03004-d X-axis tensioning mounting seat.step

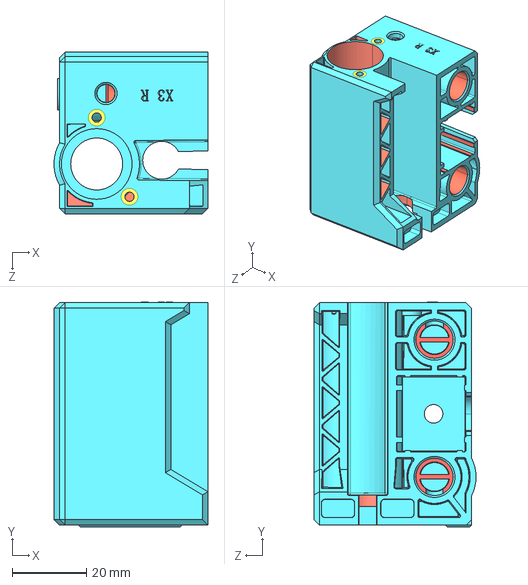
[picture p133: CAD file, 2023-06-09]
SV06 PLUS 3D/STEP/JXHSV06P-03000 X-axis component/JXHSV06P-03004-d X-axis tensioning mounting seat.step
41.5 x 60.7 x 43.7 mm
