Sovol3d/SV06-PLUS/SV06 PLUS 3D/STEP/JXHSV06P-04000 motherboard box component/JXHSV06-04005-d motherboard box hanging board.step

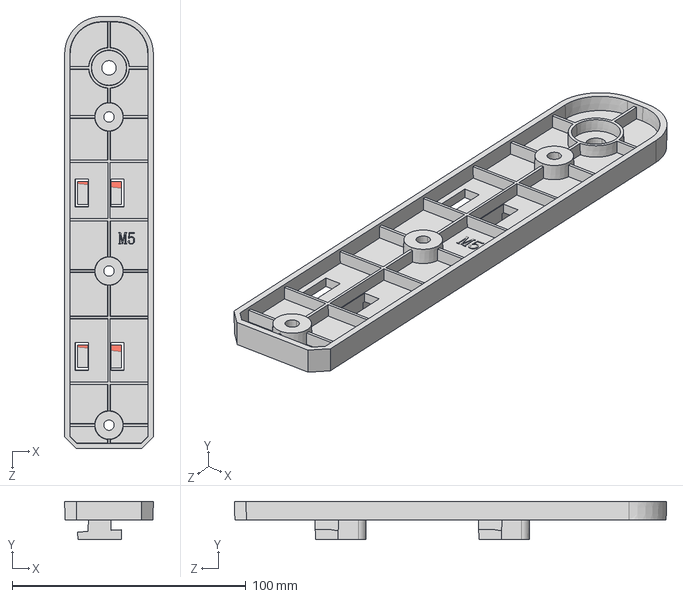
[picture p134: CAD file, 2023-06-09]
SV06 PLUS 3D/STEP/JXHSV06P-04000 motherboard box component/JXHSV06-04005-d motherboard box hanging board.step
38.0 x 16.3 x 185.0 mm
