Sovol3d/SV06-PLUS/SV06 PLUS 3D/STEP/JXHSV06P-07000 bearing bracket component/JXHSV06P-07008-d filament runout detection swing arm.step

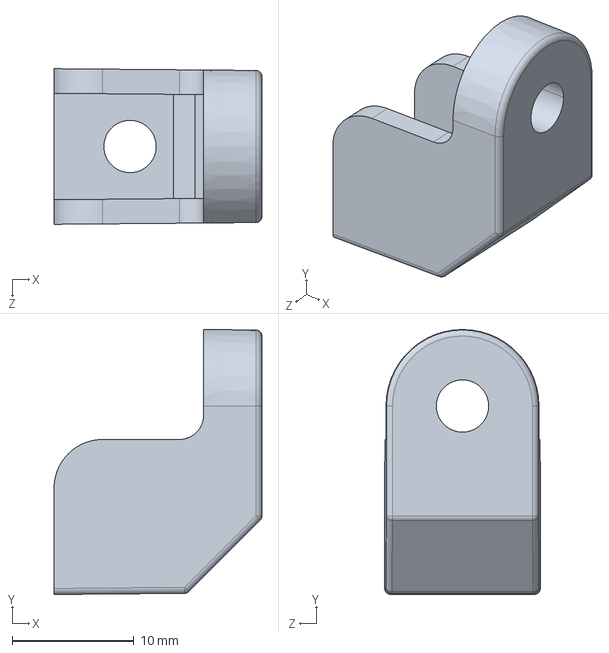
[picture p135: CAD file, 2023-06-09]
SV06 PLUS 3D/STEP/JXHSV06P-07000 bearing bracket component/JXHSV06P-07008-d filament runout detection swing arm.step
17.1 x 21.8 x 12.8 mm
