Sovol3d/SV06-PLUS/SV06 PLUS 3D/STEP/JXHSV06P-08000 Extrusion Assembly/JXHSV06P-08005-01-d fan duct cover.step

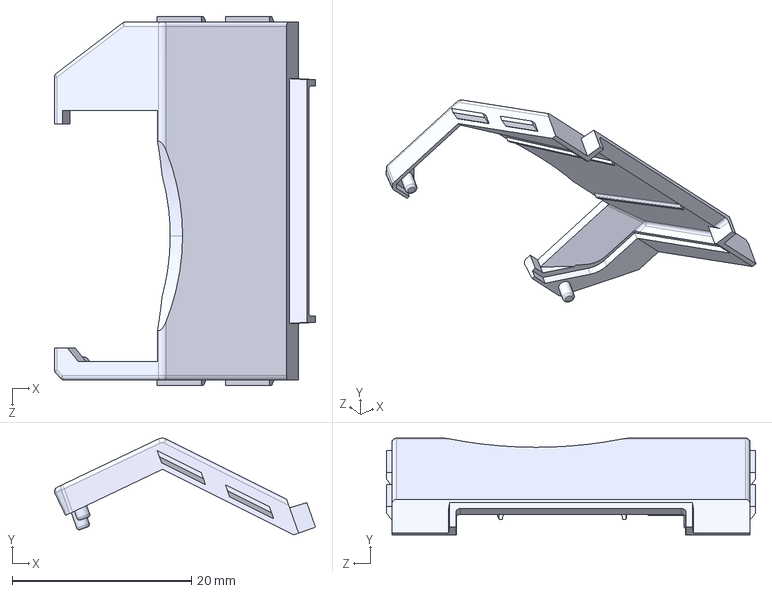
[picture p136: CAD file, 2023-06-09]
SV06 PLUS 3D/STEP/JXHSV06P-08000 Extrusion Assembly/JXHSV06P-08005-01-d fan duct cover.step
29.1 x 10.8 x 41.2 mm
