Sovol3d/SV06-PLUS/SV06 PLUS 3D/STL/JXHSV06P-06000 Touch Screen Component/Touch Screen Component 9-11 - SV01 2022屏幕下盖,ABS+PC SV01 2022屏幕下盖-1.STL

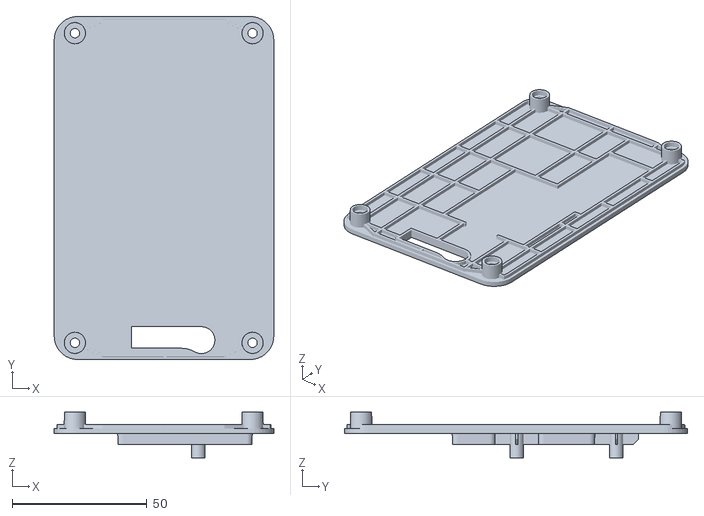
[picture p137: CAD file, 2023-06-10]
SV06 PLUS 3D/STL/JXHSV06P-06000 Touch Screen Component/Touch Screen Component 9-11 - SV01 2022屏幕下盖,ABS+PC SV01 2022屏幕下盖-1.STL
81.6 x 127.4 x 17.0
