Sovol3d/SV06-PLUS/SV06 PLUS 3D/STEP/JXHSV06P-01000 base assembly/JXHSV06P-01016-d Guide Rod Fixing Bracket.step

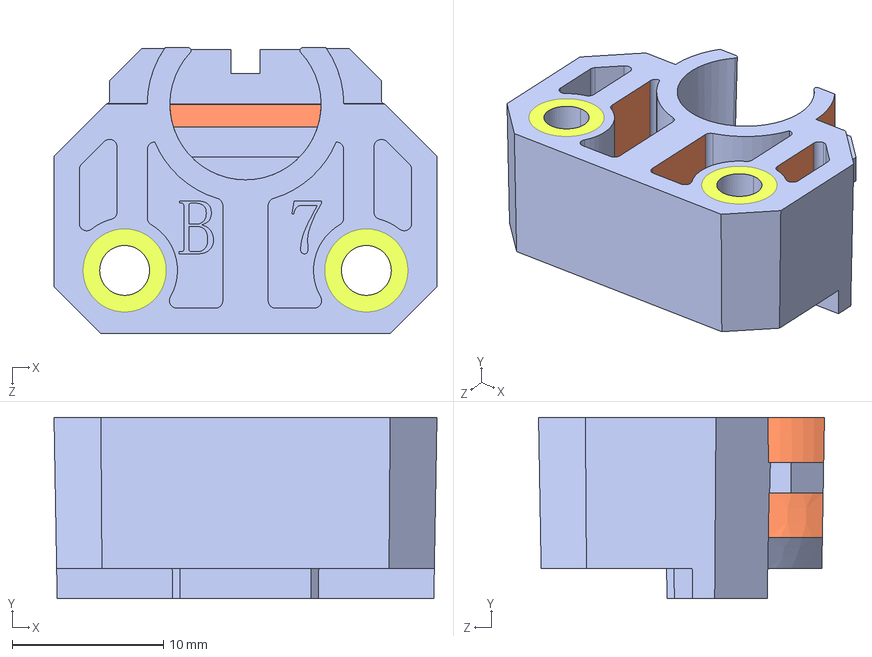
[picture p138: CAD file, 2023-06-09]
SV06 PLUS 3D/STEP/JXHSV06P-01000 base assembly/JXHSV06P-01016-d Guide Rod Fixing Bracket.step
25.3 x 12.0 x 18.9 mm
