Sovol3d/SV06-PLUS/SV06 PLUS 3D/STEP/JXHSV06P-03000 X-axis component/JXHSV06-03006-d X-axis belt tensioning knob.step

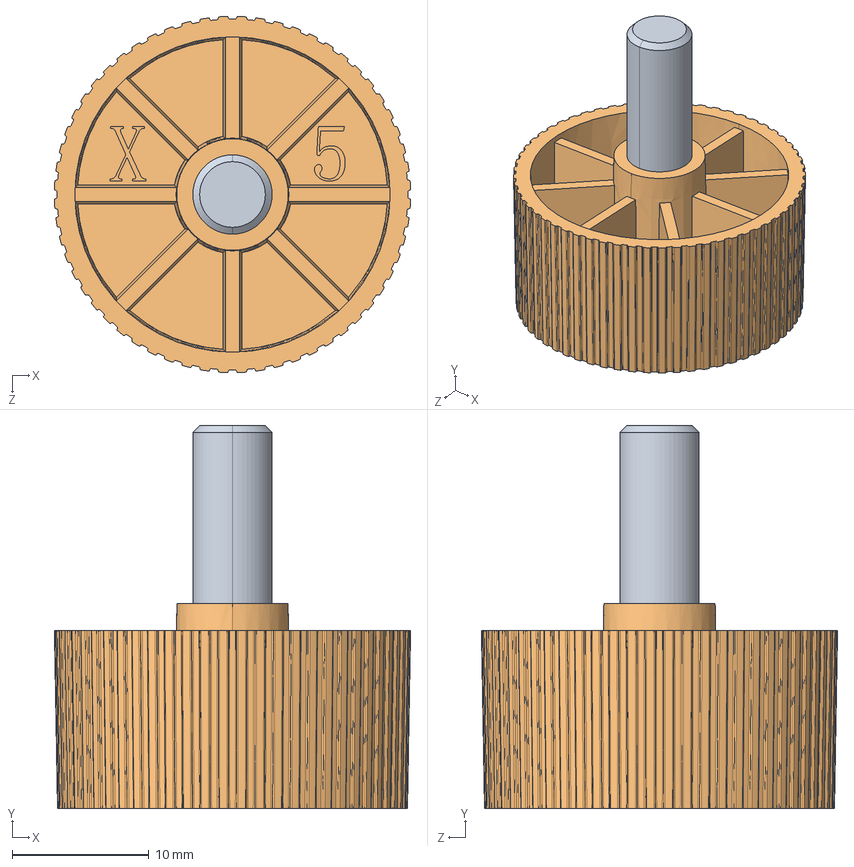
[picture p139: CAD file, 2023-06-09]
SV06 PLUS 3D/STEP/JXHSV06P-03000 X-axis component/JXHSV06-03006-d X-axis belt tensioning knob.step
26.0 x 28.0 x 26.0 mm
