Sovol3d/SV06-PLUS/SV06 PLUS 3D/STEP/JXHSV06P-08000 Extrusion Assembly/JXHSV06-08021-d fan installation plate.step

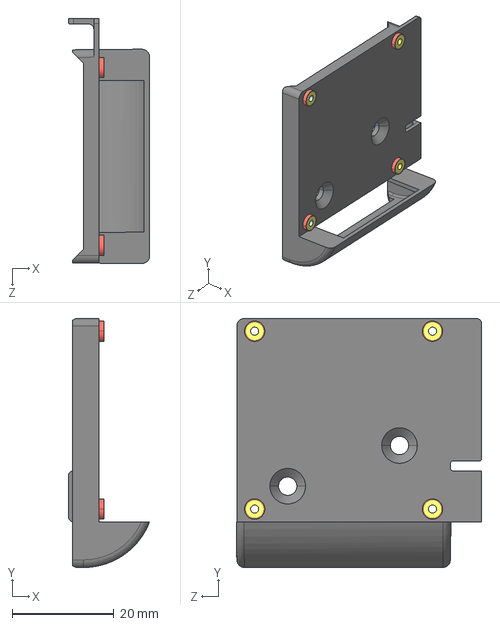
[picture p141: CAD file, 2023-06-09]
SV06 PLUS 3D/STEP/JXHSV06P-08000 Extrusion Assembly/JXHSV06-08021-d fan installation plate.step
16.0 x 49.0 x 48.3 mm
