Sovol3d/SV06-PLUS/SV06 PLUS 3D/STL/JXHSV06P-06000 Touch Screen Component/Touch Screen Component 9-11 - SV01 2022屏幕安装支架,ABS+PC SV01 2022屏幕安装支架 -1.STL

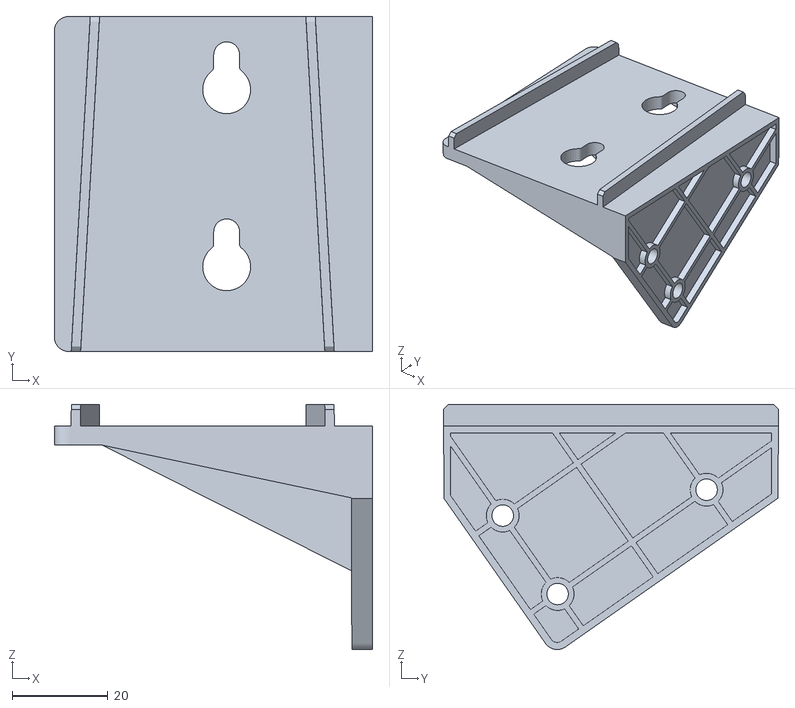
[picture p142: CAD file, 2023-06-10]
SV06 PLUS 3D/STL/JXHSV06P-06000 Touch Screen Component/Touch Screen Component 9-11 - SV01 2022屏幕安装支架,ABS+PC SV01 2022屏幕安装支架 -1.STL
66.5 x 70.0 x 51.2
