Sovol3d/SV06-PLUS/SV06 PLUS 3D/STEP/JXHSV06P-01000 base assembly/JXHSV06-01010-d Large Tensioner Knob.step

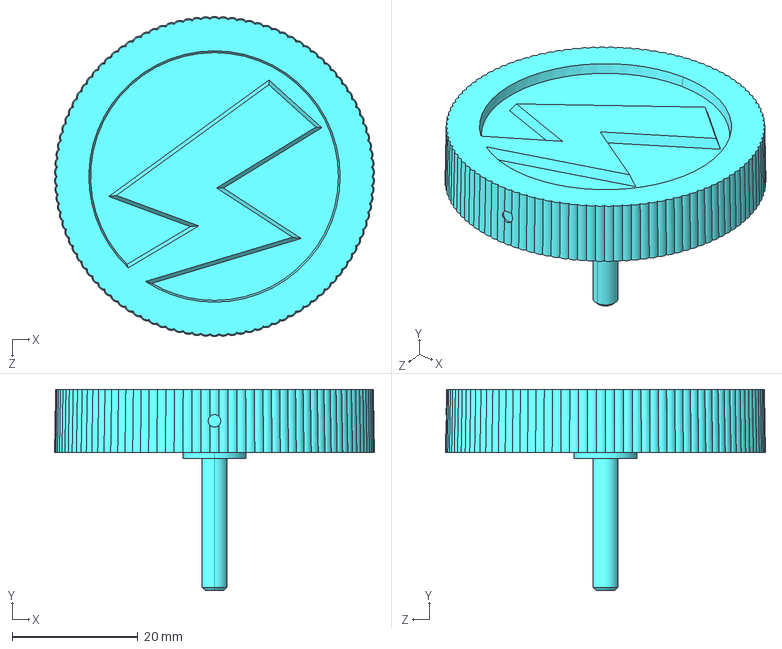
[picture p143: CAD file, 2023-06-09]
SV06 PLUS 3D/STEP/JXHSV06P-01000 base assembly/JXHSV06-01010-d Large Tensioner Knob.step
50.9 x 32.0 x 50.9 mm
