Sovol3d/SV06-PLUS/SV06 PLUS 3D/STEP/JXHSV06P-03000 X-axis component/JXHSV06P-03003-d X-axis left fixed seat.step

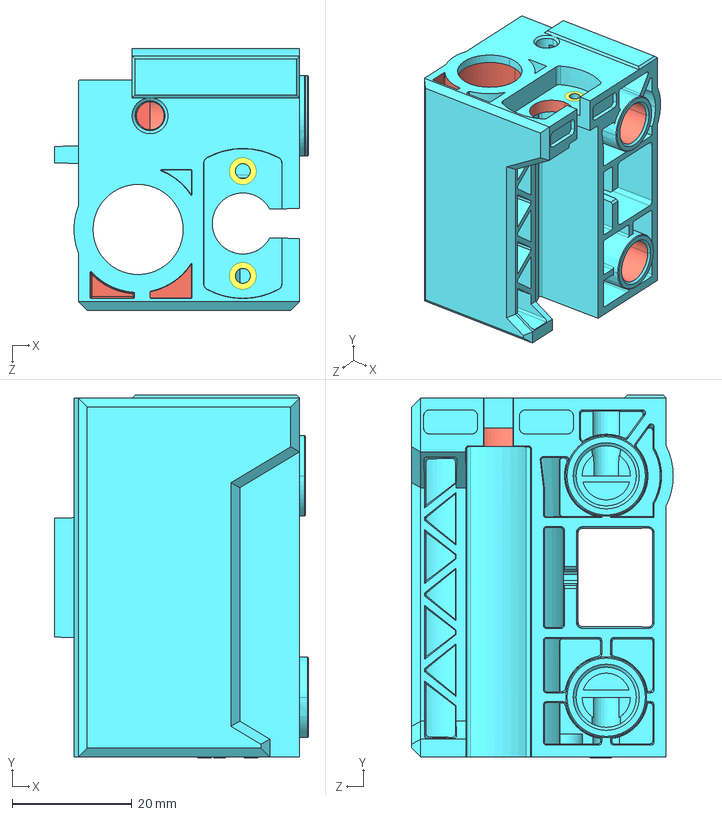
[picture p144: CAD file, 2023-06-09]
SV06 PLUS 3D/STEP/JXHSV06P-03000 X-axis component/JXHSV06P-03003-d X-axis left fixed seat.step
42.5 x 60.6 x 43.7 mm
