Sovol3d/SV06-PLUS/SV06 PLUS 3D/STEP/JXHSV06P-07000 bearing bracket component/JXHSV06P-07006-d feeder roller.step

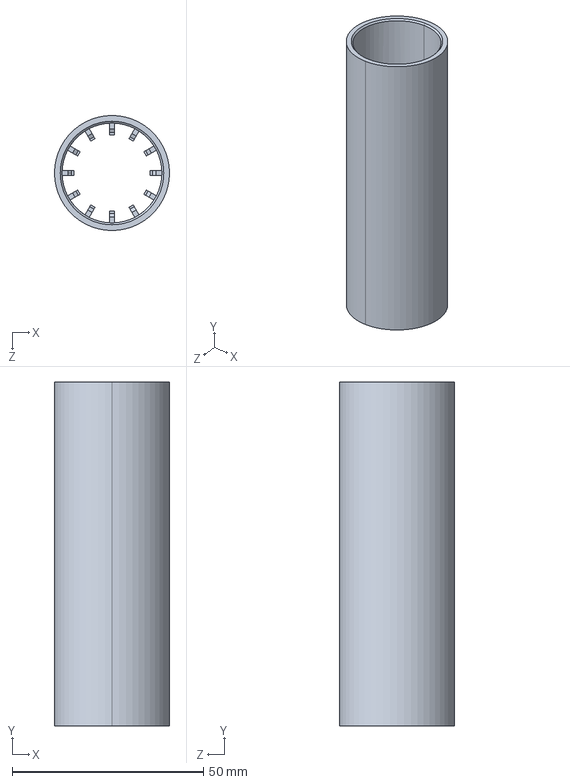
[picture p145: CAD file, 2023-06-09]
SV06 PLUS 3D/STEP/JXHSV06P-07000 bearing bracket component/JXHSV06P-07006-d feeder roller.step
30.1 x 90.0 x 30.1 mm
