Sovol3d/SV06-PLUS/SV06 PLUS 3D/STEP/JXHSV06P-08000 Extrusion Assembly/JXHSV06-08023-a copper sleeve.step

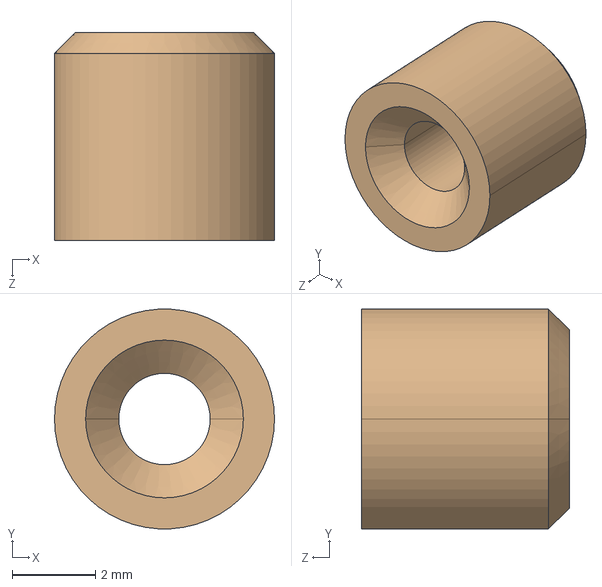
[picture p146: CAD file, 2023-06-09]
SV06 PLUS 3D/STEP/JXHSV06P-08000 Extrusion Assembly/JXHSV06-08023-a copper sleeve.step
5.30 x 5.29 x 5.00 mm
