Sovol3d/SV06-PLUS/SV06 PLUS 3D/STEP/JXHSV06P-01000 base assembly/JXHSV06P-01007-d Base Front Panel.step

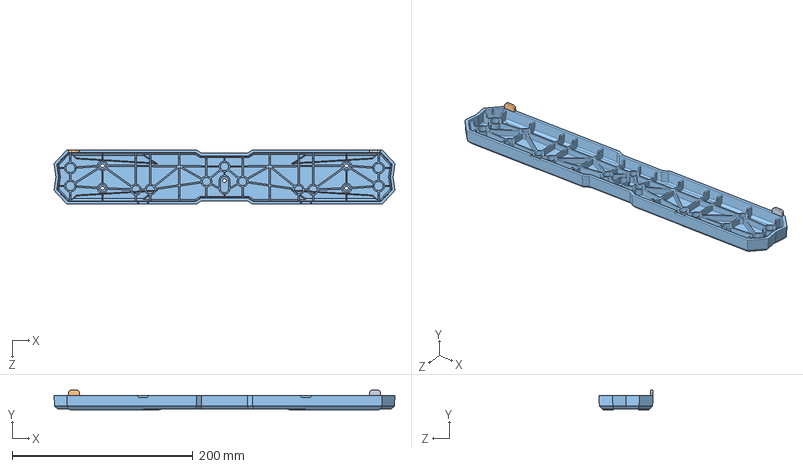
[picture p147: CAD file, 2023-06-09]
SV06 PLUS 3D/STEP/JXHSV06P-01000 base assembly/JXHSV06P-01007-d Base Front Panel.step
377.2 x 22.0 x 60.1 mm
