Sovol3d/SV06-PLUS/SV06 PLUS 3D/STEP/JXHSV06P-07000 bearing bracket component/JXHSV06P-07007-d Material Spool Bearing End Cap.step

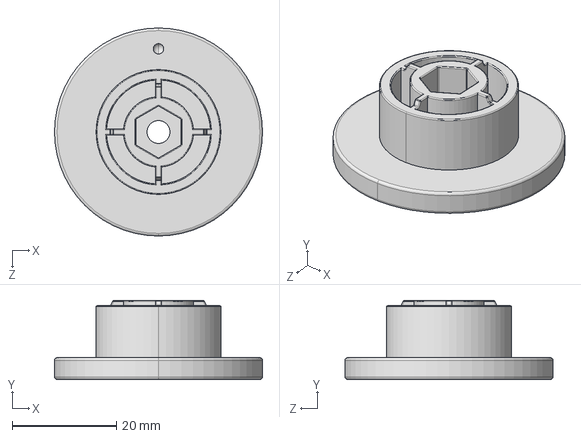
[picture p148: CAD file, 2023-06-09]
SV06 PLUS 3D/STEP/JXHSV06P-07000 bearing bracket component/JXHSV06P-07007-d Material Spool Bearing End Cap.step
40.0 x 15.2 x 40.0 mm
