Sovol3d/SV06-PLUS/SV06 PLUS 3D/STEP/JXHSV06P-08000 Extrusion Assembly/JXHSV06-08022-b interface cover panel.step

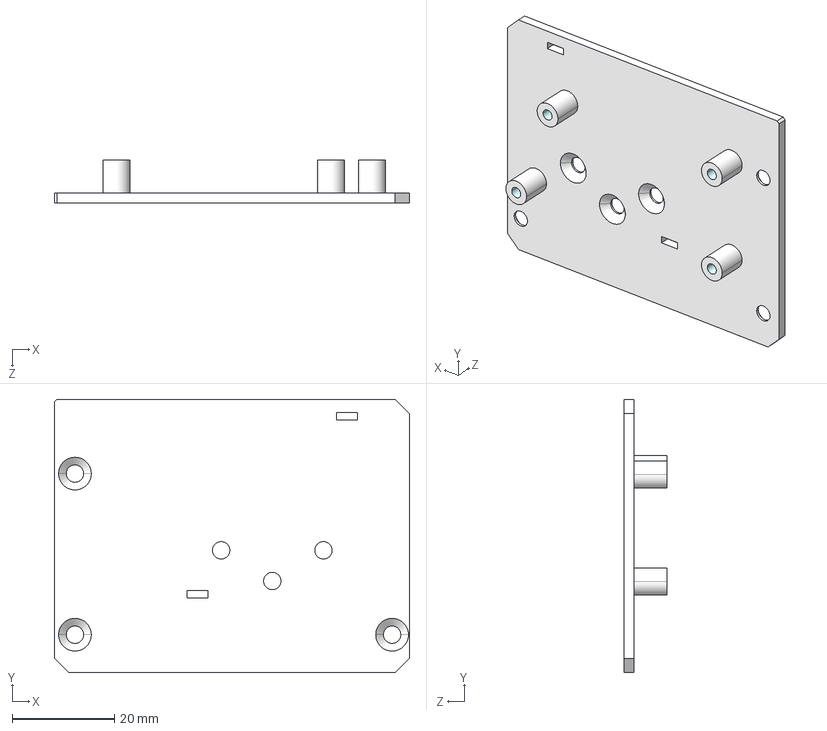
[picture p149: CAD file, 2023-06-09]
SV06 PLUS 3D/STEP/JXHSV06P-08000 Extrusion Assembly/JXHSV06-08022-b interface cover panel.step
69.4 x 53.4 x 8.50 mm
