Sovol3d/SV06-PLUS/SV06 PLUS 3D/STEP/JXHSV06P-08000 Extrusion Assembly/JXHSV06P-08009-d Automatic Leveling Seat.step

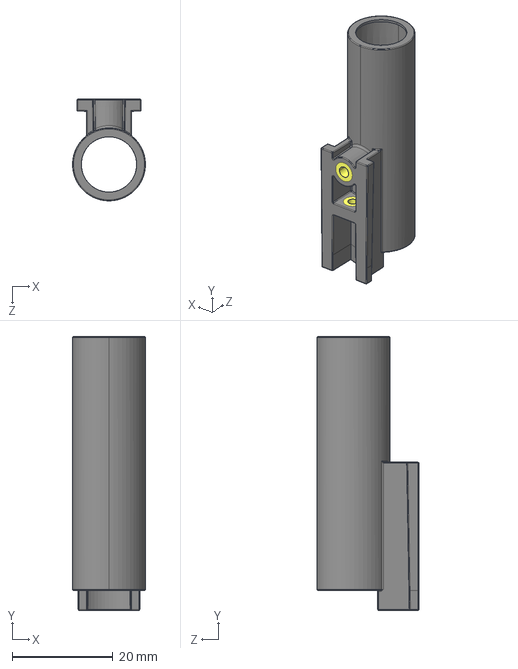
[picture p150: CAD file, 2023-06-09]
SV06 PLUS 3D/STEP/JXHSV06P-08000 Extrusion Assembly/JXHSV06P-08009-d Automatic Leveling Seat.step
14.5 x 54.5 x 20.2 mm
