Sovol3d/SV06-PLUS/SV06 PLUS 3D/STEP/JXHSV06P-01000 base assembly/JXHSV06-01009-d Hot Bed Wire Fixing Cover.step

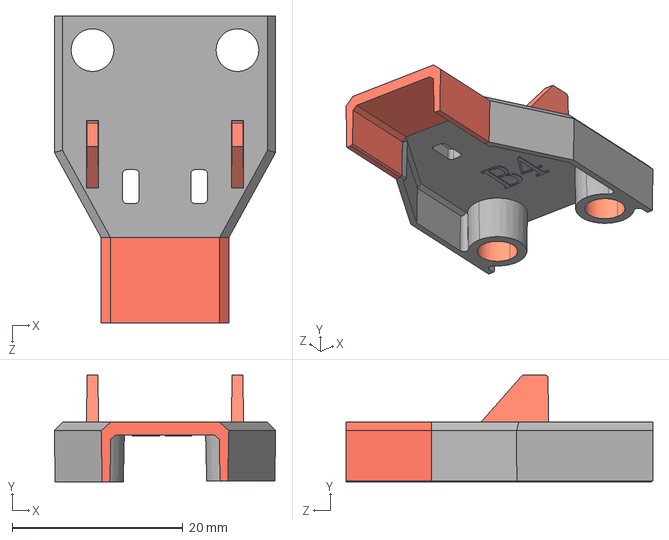
[picture p151: CAD file, 2023-06-09]
SV06 PLUS 3D/STEP/JXHSV06P-01000 base assembly/JXHSV06-01009-d Hot Bed Wire Fixing Cover.step
26.0 x 12.5 x 36.0 mm
