Sovol3d/SV06-PLUS/SV06 PLUS 3D/STEP/JXHSV06P-08000 Extrusion Assembly/JXHSV06-08006-d Nozzle Cooling Fan Bracket.step

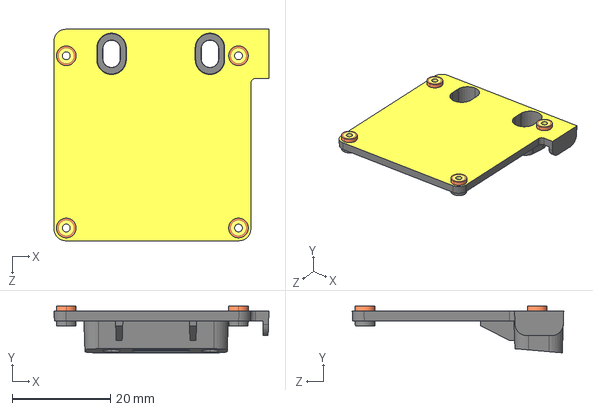
[picture p152: CAD file, 2023-06-09]
SV06 PLUS 3D/STEP/JXHSV06P-08000 Extrusion Assembly/JXHSV06-08006-d Nozzle Cooling Fan Bracket.step
43.7 x 9.50 x 43.0 mm
