Sovol3d/SV06-PLUS/SV06 PLUS 3D/STEP/JXHSV06P-01000 base assembly/JXHSV06P-01028-d hot bed wire fixing bottom cover.step

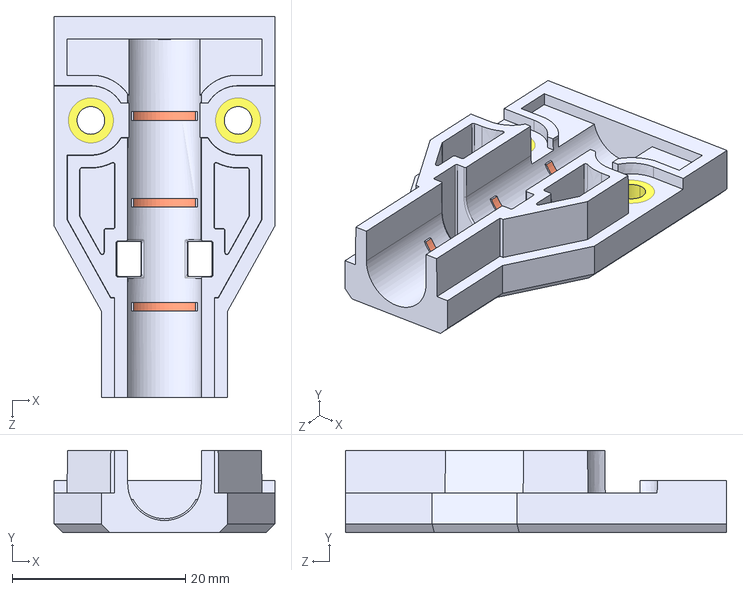
[picture p153: CAD file, 2023-06-09]
SV06 PLUS 3D/STEP/JXHSV06P-01000 base assembly/JXHSV06P-01028-d hot bed wire fixing bottom cover.step
25.5 x 9.50 x 44.0 mm
