Sovol3d/SV06-PLUS/SV06 PLUS 3D/STEP/JXHSV06P-01000 base assembly/JXHSV06-01007-d Base Belt Buckle.step

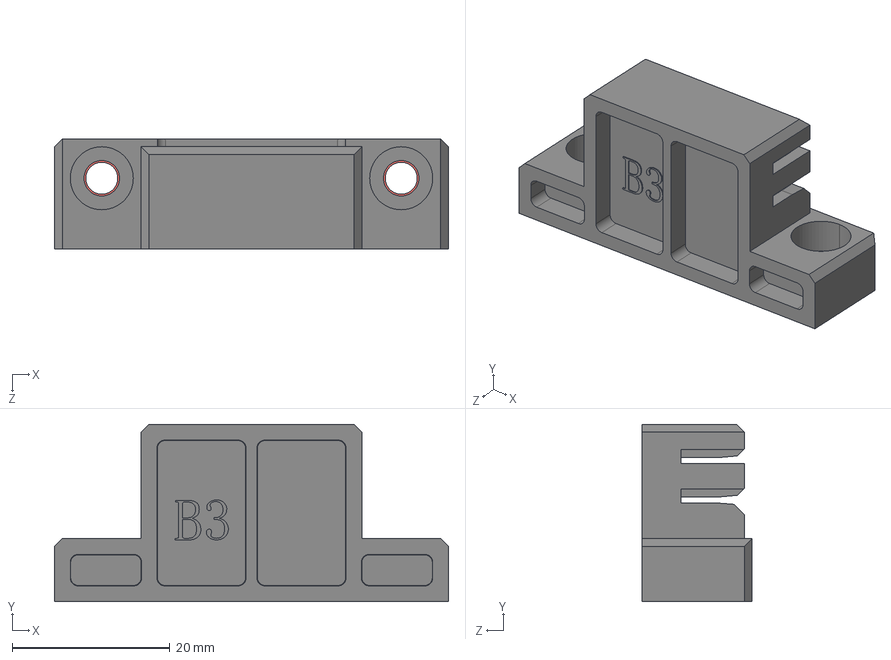
[picture p155: CAD file, 2023-06-09]
SV06 PLUS 3D/STEP/JXHSV06P-01000 base assembly/JXHSV06-01007-d Base Belt Buckle.step
50.0 x 22.5 x 14.0 mm
