Sovol3d/SV06-PLUS/SV06 PLUS 3D/STEP/JXHSV06P-08000 Extrusion Assembly/JXHSV06-08002-d Nozzle Handle (2).step

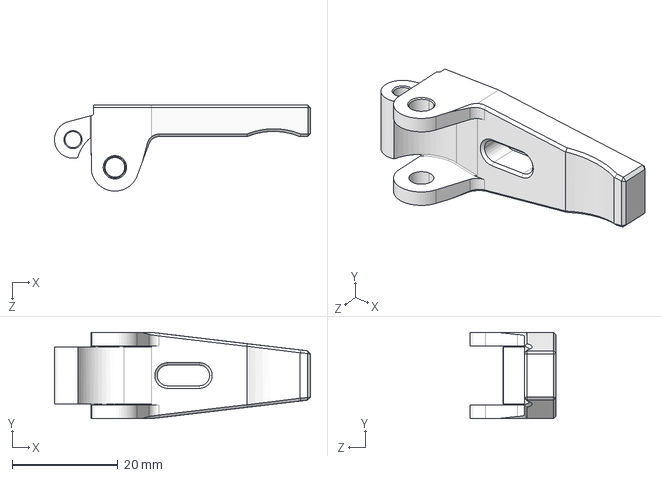
[picture p156: CAD file, 2023-06-09]
SV06 PLUS 3D/STEP/JXHSV06P-08000 Extrusion Assembly/JXHSV06-08002-d Nozzle Handle (2).step
48.4 x 16.3 x 16.3 mm
