Sovol3d/SV06-PLUS/SV06 PLUS 3D/STEP/JXHSV06P-01000 base assembly/JXHSV06P-01006-d Base Linear Bearing Housing.step

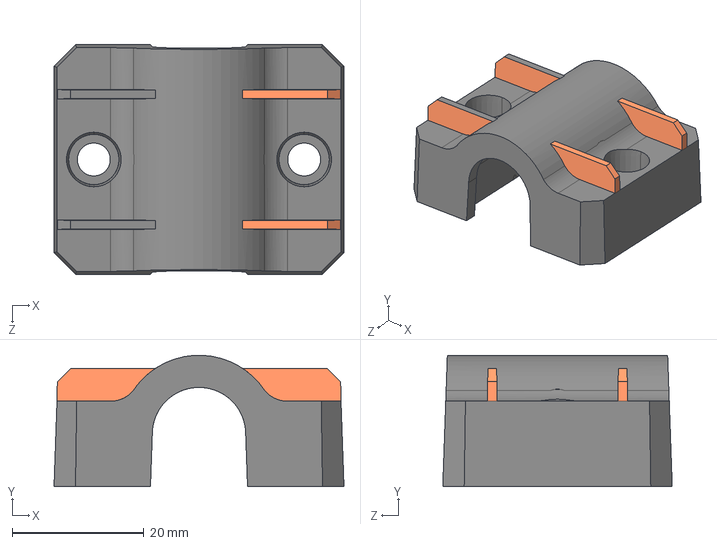
[picture p157: CAD file, 2023-06-09]
SV06 PLUS 3D/STEP/JXHSV06P-01000 base assembly/JXHSV06P-01006-d Base Linear Bearing Housing.step
44.1 x 20.0 x 34.9 mm
