Sovol3d/SV06-PLUS/SV06 PLUS 3D/STEP/JXHSV06P-08000 Extrusion Assembly/JXHSV06-08020-d leveling mounting plate.step

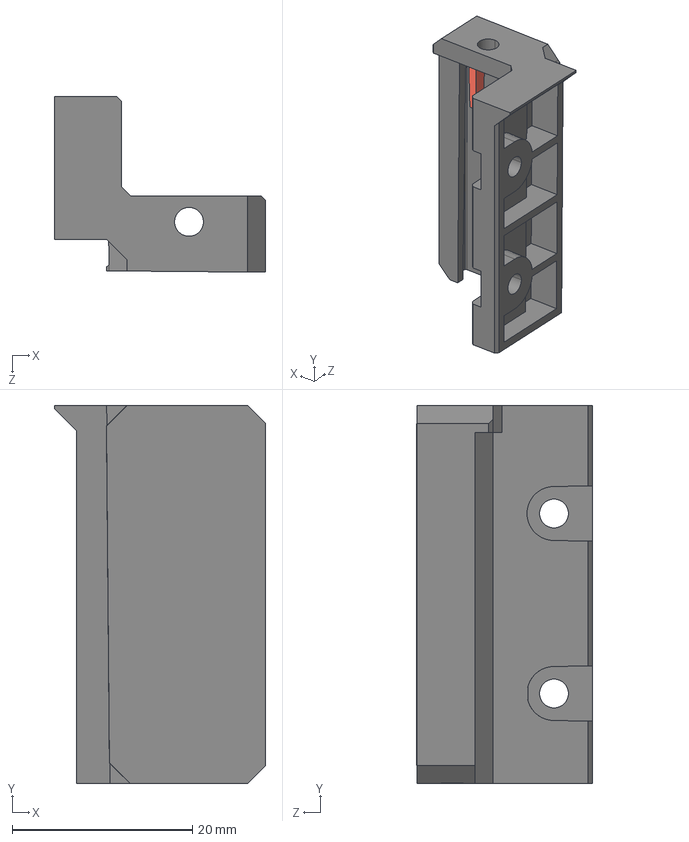
[picture p159: CAD file, 2023-06-09]
SV06 PLUS 3D/STEP/JXHSV06P-08000 Extrusion Assembly/JXHSV06-08020-d leveling mounting plate.step
23.4 x 42.0 x 19.5 mm
