Sovol3d/SV06-PLUS/SV06 PLUS 3D/STEP/JXHSV06P-08000 Extrusion Assembly/JXHSV06P-08012-d extruder carriage slider.step

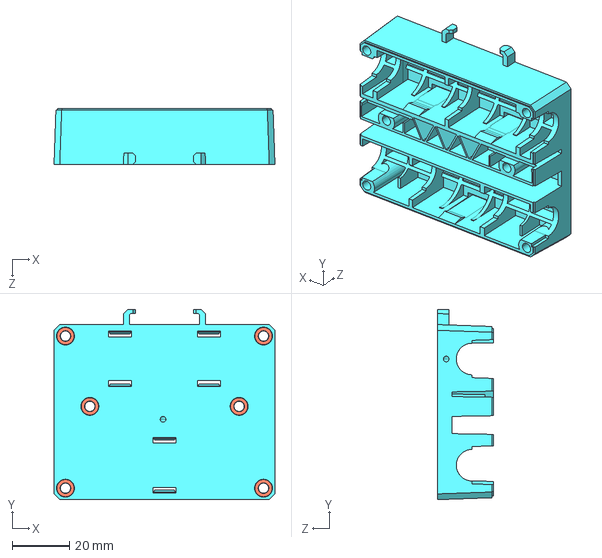
[picture p160: CAD file, 2023-06-09]
SV06 PLUS 3D/STEP/JXHSV06P-08000 Extrusion Assembly/JXHSV06P-08012-d extruder carriage slider.step
77.0 x 66.3 x 19.5 mm
