Sovol3d/SV06-PLUS/SV06 PLUS 3D/STEP/JXHSV06P-08000 Extrusion Assembly/JXHSV06P-08005-01-d Exhaust Port Cover.step

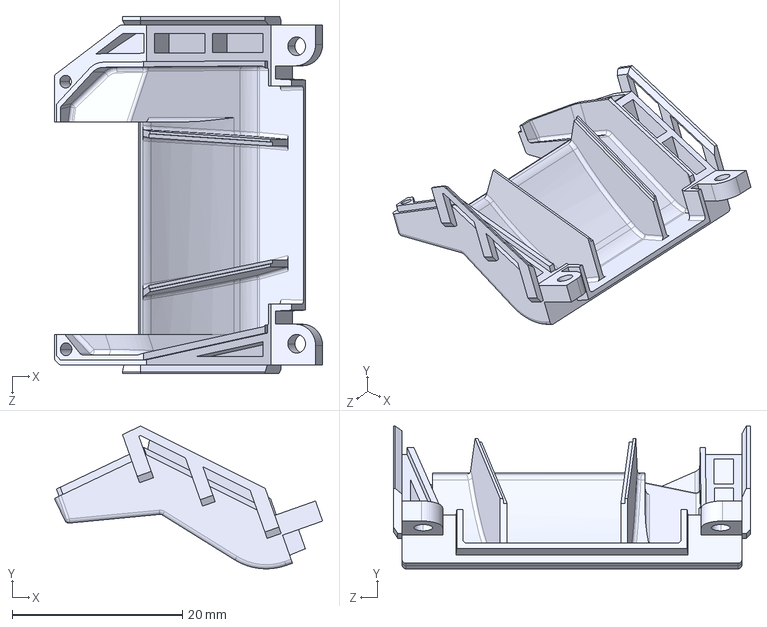
[picture p161: CAD file, 2023-06-09]
SV06 PLUS 3D/STEP/JXHSV06P-08000 Extrusion Assembly/JXHSV06P-08005-01-d Exhaust Port Cover.step
31.6 x 16.8 x 42.0 mm
