Sovol3d/SV06-PLUS/(list of files, cad)

Other CAD files:
SV06 PLUS 3D/STEP/JXHSV06P-02000 gantry component/JXHSV06P-02006-d Z-axis left guide rod fixing block.step
SV06 PLUS 3D/STEP/JXHSV06P-04000 motherboard box component/JXHSV06-04004-d motherboard box upper hinge.step
SV06 PLUS 3D/STEP/JXHSV06P-02000 gantry component/JXHSV06P-02008-d Z-axis left motor mount.step
SV06 PLUS 3D/STEP/JXHSV06P-01000 base assembly/Touch Screen Component .step
SV06 PLUS 3D/STL/JXHSV06P-01000 base assembly/JXHSV06-01007-d Base Belt Buckle.STL
SV06 PLUS 3D/STL/JXHSV06P-01000 base assembly/JXHSV06-01009-d Hot Bed Wire Fixing Cover.STL
SV06 PLUS 3D/STL/JXHSV06P-01000 base assembly/JXHSV06-01010-d Large Tensioner Knob.STL
SV06 PLUS 3D/STL/JXHSV06P-01000 base assembly/JXHSV06-01011-d Base Tensioner Mount.STL
SV06 PLUS 3D/STL/JXHSV06P-01000 base assembly/JXHSV06-01017-d Base Tensioner Fixing Piece.STL
SV06 PLUS 3D/STL/JXHSV06P-01000 base assembly/JXHSV06-01019-d Wire Clip.STL
SV06 PLUS 3D/STL/JXHSV06P-01000 base assembly/JXHSV06P-01006-d Base Linear Bearing Housing.STL
SV06 PLUS 3D/STL/JXHSV06P-01000 base assembly/JXHSV06P-01007-d Base Front Panel.STL
SV06 PLUS 3D/STL/JXHSV06P-01000 base assembly/JXHSV06P-01016-d Guide Rod Fixing Bracket.STL
SV06 PLUS 3D/STL/JXHSV06P-01000 base assembly/JXHSV06P-01028-d hot bed wire fixing bottom cover.STL
SV06 PLUS 3D/STL/JXHSV06P-02000 gantry component/JXHSV06P-02005-d Gantry crossbeam.STL
SV06 PLUS 3D/STL/JXHSV06P-02000 gantry component/JXHSV06P-02006-d Z-axis left guide rod fixing block.STL
SV06 PLUS 3D/STL/JXHSV06P-02000 gantry component/JXHSV06P-02007-d Z-axis right guide rod fixing block.STL
SV06 PLUS 3D/STL/JXHSV06P-02000 gantry component/JXHSV06P-02008-d Z-axis left motor mount.STL
SV06 PLUS 3D/STL/JXHSV06P-02000 gantry component/JXHSV06P-02009-d Z-axis right motor mount.STL
SV06 PLUS 3D/STL/JXHSV06P-03000 X-axis component/JXHSV06-03002-d X-axis motor mounting seat.STL
SV06 PLUS 3D/STL/JXHSV06P-03000 X-axis component/JXHSV06-03005-d X-axis tensioning wheel mounting seat.STL
SV06 PLUS 3D/STL/JXHSV06P-03000 X-axis component/JXHSV06-03006-d X-axis belt tensioning knob.STL
SV06 PLUS 3D/STL/JXHSV06P-03000 X-axis component/JXHSV06P-03003-d X-axis left fixed seat.STL
SV06 PLUS 3D/STL/JXHSV06P-03000 X-axis component/JXHSV06P-03004-d X-axis tensioning mounting seat.STL
SV06 PLUS 3D/STL/JXHSV06P-04000 motherboard box component/JXHSV06-04003-d motherboard box lower hinge.STL
SV06 PLUS 3D/STL/JXHSV06P-04000 motherboard box component/JXHSV06-04004-d motherboard box upper hinge.STL
SV06 PLUS 3D/STL/JXHSV06P-04000 motherboard box component/JXHSV06-04005-d motherboard box hanging board.STL
SV06 PLUS 3D/STL/JXHSV06P-04000 motherboard box component/JXHSV06-04006-d small airplane mold component.STL
SV06 PLUS 3D/STL/JXHSV06P-05000 power supply component/JXHSV06-05001-D switch power supply box.STL
SV06 PLUS 3D/STL/JXHSV06P-05000 power supply component/JXHSV06P-05000 power supply component.STL
SV06 PLUS 3D/STL/JXHSV06P-07000 bearing bracket component/JXHSV06P-07004-d feeder fixed end cap.STL
SV06 PLUS 3D/STL/JXHSV06P-07000 bearing bracket component/JXHSV06P-07005-d center shaft.STL
SV06 PLUS 3D/STL/JXHSV06P-07000 bearing bracket component/JXHSV06P-07006-d feeder roller.STL
SV06 PLUS 3D/STL/JXHSV06P-07000 bearing bracket component/JXHSV06P-07007-d Material Spool Bearing End Cap.STL
SV06 PLUS 3D/STL/JXHSV06P-07000 bearing bracket component/JXHSV06P-07008-d filament runout detection swing arm.STL
SV06 PLUS 3D/STL/JXHSV06P-08000 Extrusion Assembly/JXHSV06-08002-d Nozzle Handle (2).STL
SV06 PLUS 3D/STL/JXHSV06P-08000 Extrusion Assembly/JXHSV06-08003-d Gear Seat.STL
SV06 PLUS 3D/STL/JXHSV06P-08000 Extrusion Assembly/JXHSV06-08006-d Nozzle Cooling Fan Bracket.STL
SV06 PLUS 3D/STL/JXHSV06P-08000 Extrusion Assembly/JXHSV06-08020-d leveling mounting plate.STL
SV06 PLUS 3D/STL/JXHSV06P-08000 Extrusion Assembly/JXHSV06-08021-d fan installation plate.STL
SV06 PLUS 3D/STL/JXHSV06P-08000 Extrusion Assembly/JXHSV06-08036-D Motor Switch.STL
SV06 PLUS 3D/STL/JXHSV06P-08000 Extrusion Assembly/JXHSV06P-08005-01-d Exhaust Port Cover.STL
SV06 PLUS 3D/STL/JXHSV06P-08000 Extrusion Assembly/JXHSV06P-08005-01-d fan duct cover.STL
SV06 PLUS 3D/STL/JXHSV06P-08000 Extrusion Assembly/JXHSV06P-08009-d Automatic Leveling Seat.STL
SV06 PLUS 3D/STL/JXHSV06P-08000 Extrusion Assembly/JXHSV06P-08012-d extruder carriage slider.STL
SV06 PLUS 3D/STL/JXHSV06P-08000 Extrusion Assembly/JXHSV06P-08013-d Sliding Seat Cover Plate.STL
