Sovol3d/SV06-PLUS/SV06 PLUS-Screen/32_main/009_C_PrintFinish.jpg

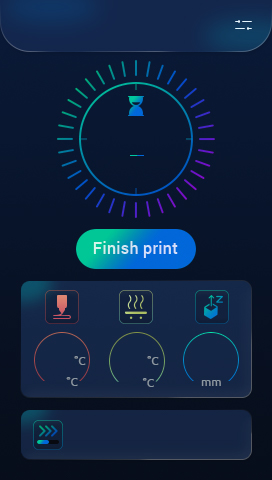
SV06 PLUS-Screen/32_main/009_C_PrintFinish.jpg
