Sovol3d/SV06-PLUS/SV06 PLUS-Screen/32_main/011_C_PrintPause.jpg

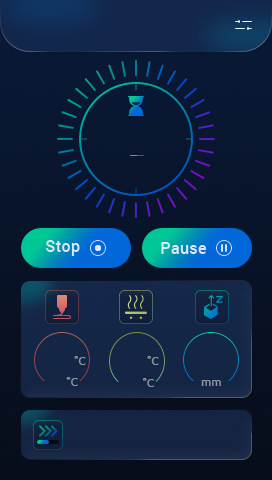
SV06 PLUS-Screen/32_main/011_C_PrintPause.jpg
