Sovol3d/SV06-PLUS/SV06 PLUS-Screen/32_main/036_C_ContinuePrint.jpg

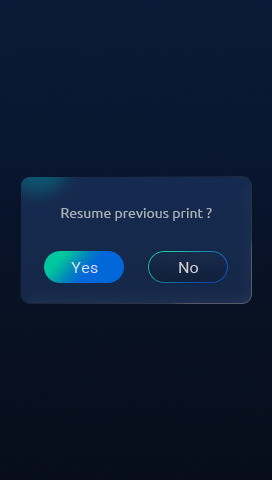
SV06 PLUS-Screen/32_main/036_C_ContinuePrint.jpg
