Sovol3d/SV06-PLUS/SV06 PLUS-Screen/32_main/046_C_CardCheckPrint.jpg

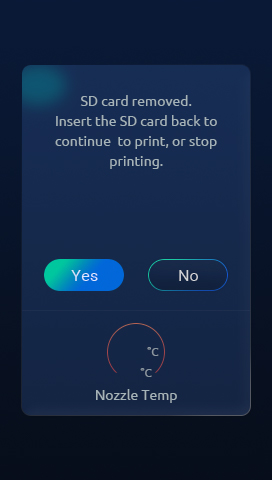
SV06 PLUS-Screen/32_main/046_C_CardCheckPrint.jpg
