Sovol3d/SV06-PLUS/SV06 PLUS-Screen/32_main/068_C_PrintConfirm.jpg

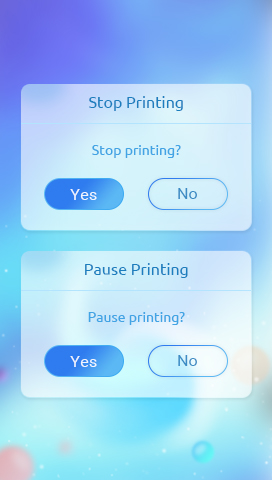
SV06 PLUS-Screen/32_main/068_C_PrintConfirm.jpg
