Sovol3d/SV06-PLUS/SV06 PLUS-Screen/32_main/091_C_ContinuePrint.jpg

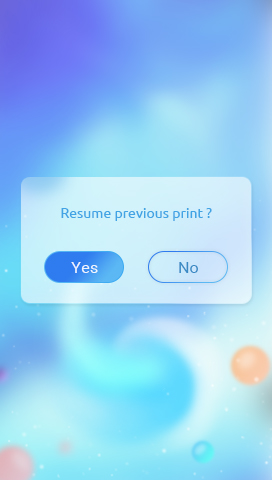
SV06 PLUS-Screen/32_main/091_C_ContinuePrint.jpg
