Sovol3d/SV06-PLUS/SV06 PLUS-Screen/32_main/102_C_PrintFile1.jpg

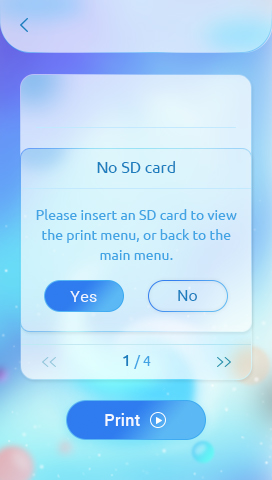
SV06 PLUS-Screen/32_main/102_C_PrintFile1.jpg
