Sovol3d/SV06-PLUS/(threads)

Thread 1 (2023-05-17):

Please enable Folder browsing support.

ccatlett1984, 2023-05-17:
The SV06 has the ability to use folders on the SC card, I'd like the same on SV06 Plus.

Sovol3d, 2023-05-22:
Hello,
What do you mean? SC card?
Could you please describe it more specific and with some pictures to show it?
Best regards,
Jan
website: sovol3d.com
Follow us to get an exclusive 3D printing information
Sovol Official User Group: https://www.facebook.com/groups/sovol3d <https://www.facebook.com/sovol3d/ >
Facebook Page:https://www.facebook.com/sovol3d <https://twitter.com/Sovol3d >
Youtube: https://www.youtube.com/channel/UCsKntuwh7dhAGep8R6kasog <https://www.youtube.com/channel/UCsKntuwh7dhAGep8R6kasog >
------------------------------------------------------------------
From:ccatlett1984 ***@***.***>
Sent At:2023 May 18 (Thu.) 07:06
To:Sovol3d/SV06-PLUS ***@***.***>
Cc:Subscribed ***@***.***>
Subject:[Sovol3d/SV06-PLUS] Please enable Folder browsing support. (Issue #1)
The SV06 has the ability to use folders on the SC card, I'd like the same on SV06 Plus.
—
Reply to this email directly, view it on GitHub <https://github.com/Sovol3d/SV06-PLUS/issues/1 >, or unsubscribe <https://github.com/notifications/unsubscribe-auth/AXAZJAISUT7T7SEDJY5BKD3XGVKXFANCNFSM6AAAAAAYFXJB5I >.
You are receiving this because you are subscribed to this thread.Message ID: ***@***.***>

ccatlett1984, 2023-05-22:
Sorry for the typo, I mean the SD card.

Sovol3d, 2023-05-26:
Hello,
It can. You can connect it with a USB or card reader.
Best regards,
Jan
website: sovol3d.com
Follow us to get an exclusive 3D printing information
Sovol Official User Group: https://www.facebook.com/groups/sovol3d <https://www.facebook.com/sovol3d/ >
Facebook Page:https://www.facebook.com/sovol3d <https://twitter.com/Sovol3d >
Youtube: https://www.youtube.com/channel/UCsKntuwh7dhAGep8R6kasog <https://www.youtube.com/channel/UCsKntuwh7dhAGep8R6kasog >
------------------------------------------------------------------
From:ccatlett1984 ***@***.***>
Sent At:2023 May 23 (Tue.) 06:41
To:Sovol3d/SV06-PLUS ***@***.***>
Cc:info ***@***.***>; Comment ***@***.***>
Subject:Re: [Sovol3d/SV06-PLUS] Please enable Folder browsing support. (Issue #1)
Sorry for the typo, I mean the SD card.
—
Reply to this email directly, view it on GitHub <https://github.com/Sovol3d/SV06-PLUS/issues/1#issuecomment-1558132486 >, or unsubscribe <https://github.com/notifications/unsubscribe-auth/AXAZJAJ5U3GDMY73QAVNWB3XHPTSBANCNFSM6AAAAAAYFXJB5I >.
You are receiving this because you commented.Message ID: ***@***.***>

ccatlett1984, 2023-05-26:
No, it can NOT.
Folders do not appear at all in the file selection dialog screen.

Sovol3d, 2023-05-31:
Hello,
May I know your order number?
Could you please take a short video to show it?
website: sovol3d.com
Follow us to get an exclusive 3D printing information
Sovol Official User Group: https://www.facebook.com/groups/sovol3d <https://www.facebook.com/sovol3d/ >
Facebook Page:https://www.facebook.com/sovol3d <https://twitter.com/Sovol3d >
Youtube: https://www.youtube.com/channel/UCsKntuwh7dhAGep8R6kasog <https://www.youtube.com/channel/UCsKntuwh7dhAGep8R6kasog >
------------------------------------------------------------------
From:ccatlett1984 ***@***.***>
Sent At:2023 May 27 (Sat.) 05:22
To:Sovol3d/SV06-PLUS ***@***.***>
Cc:info ***@***.***>; Comment ***@***.***>
Subject:Re: [Sovol3d/SV06-PLUS] Please enable Folder browsing support. (Issue #1)
No, it can NOT.
 Folders do not appear at all in the file selection dialog screen.
—
Reply to this email directly, view it on GitHub <https://github.com/Sovol3d/SV06-PLUS/issues/1#issuecomment-1564970576 >, or unsubscribe <https://github.com/notifications/unsubscribe-auth/AXAZJAM6M6AE4VAOGE2BCJDXIENJBANCNFSM6AAAAAAYFXJB5I >.
You are receiving this because you commented.Message ID: ***@***.***>

TerkWerX, 2023-09-22:
ever fixed?

ccatlett1984, 2023-09-22:
Nope, they don't seem to be working on it at all....

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

smkent, 2023-12-15:
[In digging around the SV06 Plus firmware to get LCD progress working for USB prints](https://github.com/smkent/sovol-sv06-plus-firmware), I've learned a bit about how the LCD works and how file names are populated. The LCD is its own little microcontroller that talks to the printer's own firmware via a serial connection; it's not like a monitor driven by a display signal from a computer. What this means is the LCD's pages are all preprogrammed and the printer firmware tells the LCD which page to go to in response to certain events, with some fields for populating data (like file names).

The SV06 Plus LCD has 4 predefined file selection pages with 5 file name slots each, and the printer firmware correspondingly fills up to these [20 file name slots](https://github.com/Sovol3d/SV06-PLUS/blob/ea9f2cb03ba9eecddcb0d17d33bc66e2e2f98873/MarlinSV06Plus/Marlin/src/lcd/sv06p/LCD_RTS.h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) (with [up to 20 characters each](https://github.com/Sovol3d/SV06-PLUS/blob/ea9f2cb03ba9eecddcb0d17d33bc66e2e2f98873/MarlinSV06Plus/Marlin/src/lcd/sv06p/LCD_RTS.h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)) using [file names from the root directory of the SD card](https://github.com/Sovol3d/SV06-PLUS/blob/ea9f2cb03ba9eecddcb0d17d33bc66e2e2f98873/MarlinSV06Plus/Marlin/src/lcd/sv06p/LCD_RTS.cpp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).

It might be possible to implement subdirectory navigation using the 4 predefined LCD file list screens. Navigation would need to be implemented in the firmware's `LCD_RTS.cpp` beyond the simple file listing logic that's already there.

ccatlett1984, 2023-12-15:
Yep, saw that when i was converting my lcd/printer over to klipper.

Thread 2 (2023-05-17):

Enable scrolling for longer filenames

ccatlett1984, 2023-05-17:
The SV06 will scroll filenames that do not fit on the screen, it would be nice if the SV06 Plus would do this for the selected file prior to starting the print. Currently I have to use short names, or only put a few files on the SD card to ensure selecting the correct file to print.

Andy3dprinter, 2023-08-04:
Yes I agree. Please enable longer file names like the SV06 does. And can you also update Marlin to the newest version? So we can have input shaping? tks

Sovol3d, 2023-08-07:
Hello,
I am sorry for the delay in the response during the weekend off. I hope you had a nice weekend off.
We are sorry for the inconvenience caused to you. Regarding the problem you encountered, we suggest you don't use special symbol for naming, and file names should not exceed 14 characters.
Best regards,
Jan
website: sovol3d.com
Follow us to get an exclusive 3D printing information
Sovol Official User Group: https://www.facebook.com/groups/sovol3d <https://www.facebook.com/sovol3d/ >
Facebook Page:https://www.facebook.com/sovol3d <https://twitter.com/Sovol3d >
Youtube: https://www.youtube.com/channel/UCsKntuwh7dhAGep8R6kasog <https://www.youtube.com/channel/UCsKntuwh7dhAGep8R6kasog >
------------------------------------------------------------------
From:Andy3dprinter ***@***.***>
Sent At:2023 Aug. 4 (Fri.) 11:38
To:Sovol3d/SV06-PLUS ***@***.***>
Cc:Subscribed ***@***.***>
Subject:Re: [Sovol3d/SV06-PLUS] Enable scrolling for longer filenames (Issue #2)
Yes I agree. Please enable longer file names like the SV06 does. And can you also update Marlin to the newest version? So we can have input shaping? tks
—
Reply to this email directly, view it on GitHub <https://github.com/Sovol3d/SV06-PLUS/issues/2#issuecomment-1664924753 >, or unsubscribe <https://github.com/notifications/unsubscribe-auth/AXAZJALWGLGY5EGFAZQHHRTXTRVBXANCNFSM6AAAAAAYFXKMYQ >.
You are receiving this because you are subscribed to this thread.Message ID: ***@***.***>

ccatlett1984, 2023-08-07:
So, the official stance is that the SV06 gets long filename support.... And
the Plus doesn't.....

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

Sovol3d, 2023-08-08:
Hello,
We recommend less than 14 characters in case the printer doesn't recognize your file. If the file name is too long, the screen scrolls through the file name.
Best regards,
Jan
website: sovol3d.com
Follow us to get an exclusive 3D printing information
Sovol Official User Group: https://www.facebook.com/groups/sovol3d <https://www.facebook.com/sovol3d/ >
Facebook Page:https://www.facebook.com/sovol3d <https://twitter.com/Sovol3d >
Youtube: https://www.youtube.com/channel/UCsKntuwh7dhAGep8R6kasog <https://www.youtube.com/channel/UCsKntuwh7dhAGep8R6kasog >
------------------------------------------------------------------
From:ccatlett1984 ***@***.***>
Sent At:2023 Aug. 7 (Mon.) 21:10
To:Sovol3d/SV06-PLUS ***@***.***>
Cc:info ***@***.***>; Comment ***@***.***>
Subject:Re: [Sovol3d/SV06-PLUS] Enable scrolling for longer filenames (Issue #2)
 So, the official stance is that the SV06 gets long filename support.... And
 the Plus doesn't.....
 On Sun, Aug 6, 2023, 11:41 PM Sovol3d ***@***.***> wrote:
 > Hello,
 > I am sorry for the delay in the response during the weekend off. I hope
 > you had a nice weekend off.
 > We are sorry for the inconvenience caused to you. Regarding the problem
 > you encountered, we suggest you don't use special symbol for naming, and
 > file names should not exceed 14 characters.
 > Best regards,
 > Jan
 > website: sovol3d.com
 > Follow us to get an exclusive 3D printing information
 > Sovol Official User Group: https://www.facebook.com/groups/sovol3d <https://www.facebook.com/groups/sovol3d > <
 > https://www.facebook.com/sovol3d/ <https://www.facebook.com/sovol3d/ > >
 > Facebook Page:https://www.facebook.com/sovol3d <https://www.facebook.com/sovol3d > <
 > https://twitter.com/Sovol3d <https://twitter.com/Sovol3d > >
 > Youtube: https://www.youtube.com/channel/UCsKntuwh7dhAGep8R6kasog <https://www.youtube.com/channel/UCsKntuwh7dhAGep8R6kasog > <
 > https://www.youtube.com/channel/UCsKntuwh7dhAGep8R6kasog <https://www.youtube.com/channel/UCsKntuwh7dhAGep8R6kasog > >
 > ------------------------------------------------------------------
 > From:Andy3dprinter ***@***.***>
 > Sent At:2023 Aug. 4 (Fri.) 11:38
 > To:Sovol3d/SV06-PLUS ***@***.***>
 > Cc:Subscribed ***@***.***>
 > Subject:Re: [Sovol3d/SV06-PLUS] Enable scrolling for longer filenames
 > (Issue #2)
 > Yes I agree. Please enable longer file names like the SV06 does. And can
 > you also update Marlin to the newest version? So we can have input shaping?
 > tks
 > —
 > Reply to this email directly, view it on GitHub <
 > https://github.com/Sovol3d/SV06-PLUS/issues/2#issuecomment-1664924753 <https://github.com/Sovol3d/SV06-PLUS/issues/2#issuecomment-1664924753 > >,
 > or unsubscribe <
 > https://github.com/notifications/unsubscribe-auth/AXAZJALWGLGY5EGFAZQHHRTXTRVBXANCNFSM6AAAAAAYFXKMYQ <https://github.com/notifications/unsubscribe-auth/AXAZJALWGLGY5EGFAZQHHRTXTRVBXANCNFSM6AAAAAAYFXKMYQ >
 > >.
 > You are receiving this because you are subscribed to this thread.Message
 > ID: ***@***.***>
 >
 > —
 > Reply to this email directly, view it on GitHub
 > <https://github.com/Sovol3d/SV06-PLUS/issues/2#issuecomment-1667138573> <https://github.com/Sovol3d/SV06-PLUS/issues/2#issuecomment-1667138573> >,
 > or unsubscribe
 > <https://github.com/notifications/unsubscribe-auth/ABY4LWJVF5XFHZGO5DRLEQDXUBPXDANCNFSM6AAAAAAYFXKMYQ> <https://github.com/notifications/unsubscribe-auth/ABY4LWJVF5XFHZGO5DRLEQDXUBPXDANCNFSM6AAAAAAYFXKMYQ> >
 > .
 > You are receiving this because you authored the thread.Message ID:
 > ***@***.***>
 >
—
Reply to this email directly, view it on GitHub <https://github.com/Sovol3d/SV06-PLUS/issues/2#issuecomment-1667831828 >, or unsubscribe <https://github.com/notifications/unsubscribe-auth/AXAZJAJQ6RXIV7TPMU3UVRLXUDSNPANCNFSM6AAAAAAYFXKMYQ >.
You are receiving this because you commented.Message ID: ***@***.***>

smkent, 2023-12-15:
Copying [my comment from #1](https://github.com/Sovol3d/SV06-PLUS/issues/1#issuecomment-1858395698):

> [In digging around the SV06 Plus firmware to get LCD progress working for USB prints](https://github.com/smkent/sovol-sv06-plus-firmware), I've learned a bit about how the LCD works and how file names are populated. The LCD is its own little microcontroller that talks to the printer's own firmware via a serial connection; it's not like a monitor driven by a display signal from a computer. What this means is the LCD's pages are all preprogrammed and the printer firmware tells the LCD which page to go to in response to certain events, with some fields for populating data (like file names).
>
> The SV06 Plus LCD has 4 predefined file selection pages with 5 file name slots each, and the printer firmware correspondingly fills up to these [20 file name slots](https://github.com/Sovol3d/SV06-PLUS/blob/ea9f2cb03ba9eecddcb0d17d33bc66e2e2f98873/MarlinSV06Plus/Marlin/src/lcd/sv06p/LCD_RTS.h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) (with [up to 20 characters each](https://github.com/Sovol3d/SV06-PLUS/blob/ea9f2cb03ba9eecddcb0d17d33bc66e2e2f98873/MarlinSV06Plus/Marlin/src/lcd/sv06p/LCD_RTS.h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)) using [file names from the root directory of the SD card](https://github.com/Sovol3d/SV06-PLUS/blob/ea9f2cb03ba9eecddcb0d17d33bc66e2e2f98873/MarlinSV06Plus/Marlin/src/lcd/sv06p/LCD_RTS.cpp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).

I don't have an SV06, but my (possibly incorrect) understanding of the SV06 LCD and other simple text LCDs is the firmware sends the LCD the full text strings (e.g. long file names), and the LCD performs the scrolling. The SV06 Plus' LCD as programmed has fields that can be populated (e.g. file names), but those are displayed statically.

It might be possible to implement long file name scrolling in the SV06 Plus firmware. The firmware's `LCD_RTS.cpp` would need new logic to keep track of whether the current LCD screen is a file name display, and would need to update the LCD's file name fields for the current page every tick with a different string to simulate scrolling (e.g. tick 1 `"file..."`, tick 2 `"...ile_n..."`, tick 3 `"..._name"`).

Thread 4 (2023-09-09):

Update Marlin to access M423

Minner1337, 2023-09-09:
Since this version of Marlin is 2.0.9.2 X Axis Twist is a common issue with this style of Printers i'd recommend updating to atleast Version 2.0.9.4 and activating M423 (X Twist Compensation) to give people the ability to compensate for this issue as it makes leveling the printbed not possible as is without manually trying to bend the rods. Which is obviously not a good idea.

smkent, 2023-12-16:
I've managed to integrate the upstream Marlin 2.0.9.2 repository history with Sovol's changes in my fork: https://github.com/smkent/sovol-sv06-plus-firmware

This could be used as a base to merge in successive Marlin versions while keeping Sovol's changes for the SV06 Plus.

Thread 7 (2023-12-24):

Enable M300 support in G-CODE

PosquitoSan, 2023-12-24:
It would be nice if M300 was enabled in Marlin. M300 it a very useful command to play a beep during the execution of the G-CODE, and can be used in the end of the code to warn a user when the print is finished.

M300 can be very easily added on the G-CODE using the Custom G-Code section on the most used slicers sorftares, but the printer firmware doesn't execute it.

Thread 12 (2025-04-03):

Auto-remount for SD card when using an extender cable

pulsar123, 2025-04-03:
When using an extender SD card cable, SD card is not remounted when replacing a card. The only workaround is to turn the printer OFF and ON. Can you please add a SD card auto re-mount inside the code? E.g. when one clicks on the icon "Print from the file".
