Sovol3d/SV06-PLUS/SV06 PLUS Mechanical PDF/JXHSV06P-08021-g power cable（connect to adapter）.pdf

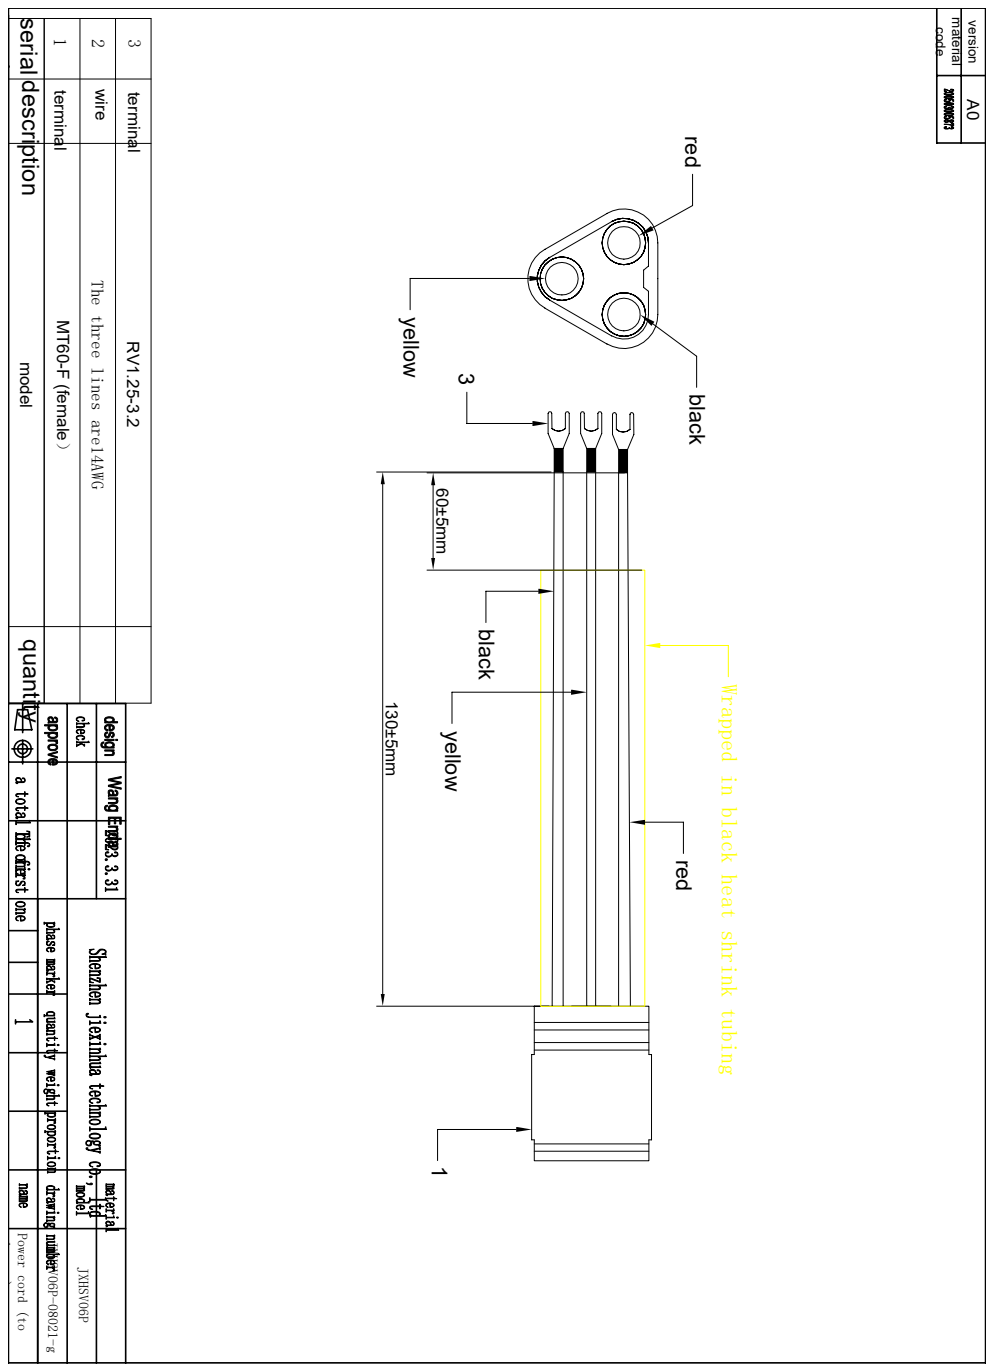
[picture p172: page 1]

serial description quantity 1

3 130±5mm 60±5mm Wrapped in black heat shrink tubing 1 terminal black yellow red 3 wire terminal Power cord (to JXHSV06P-08021-g JXHSV06P MT60-F (female） The three lines are14AWG RV1.25-3.2 model version A0 material code yellow red black
