Sovol3d/SV06-PLUS/SV06 PLUS Mechanical PDF/JXHSV06P-08020-g touch screen cable.pdf

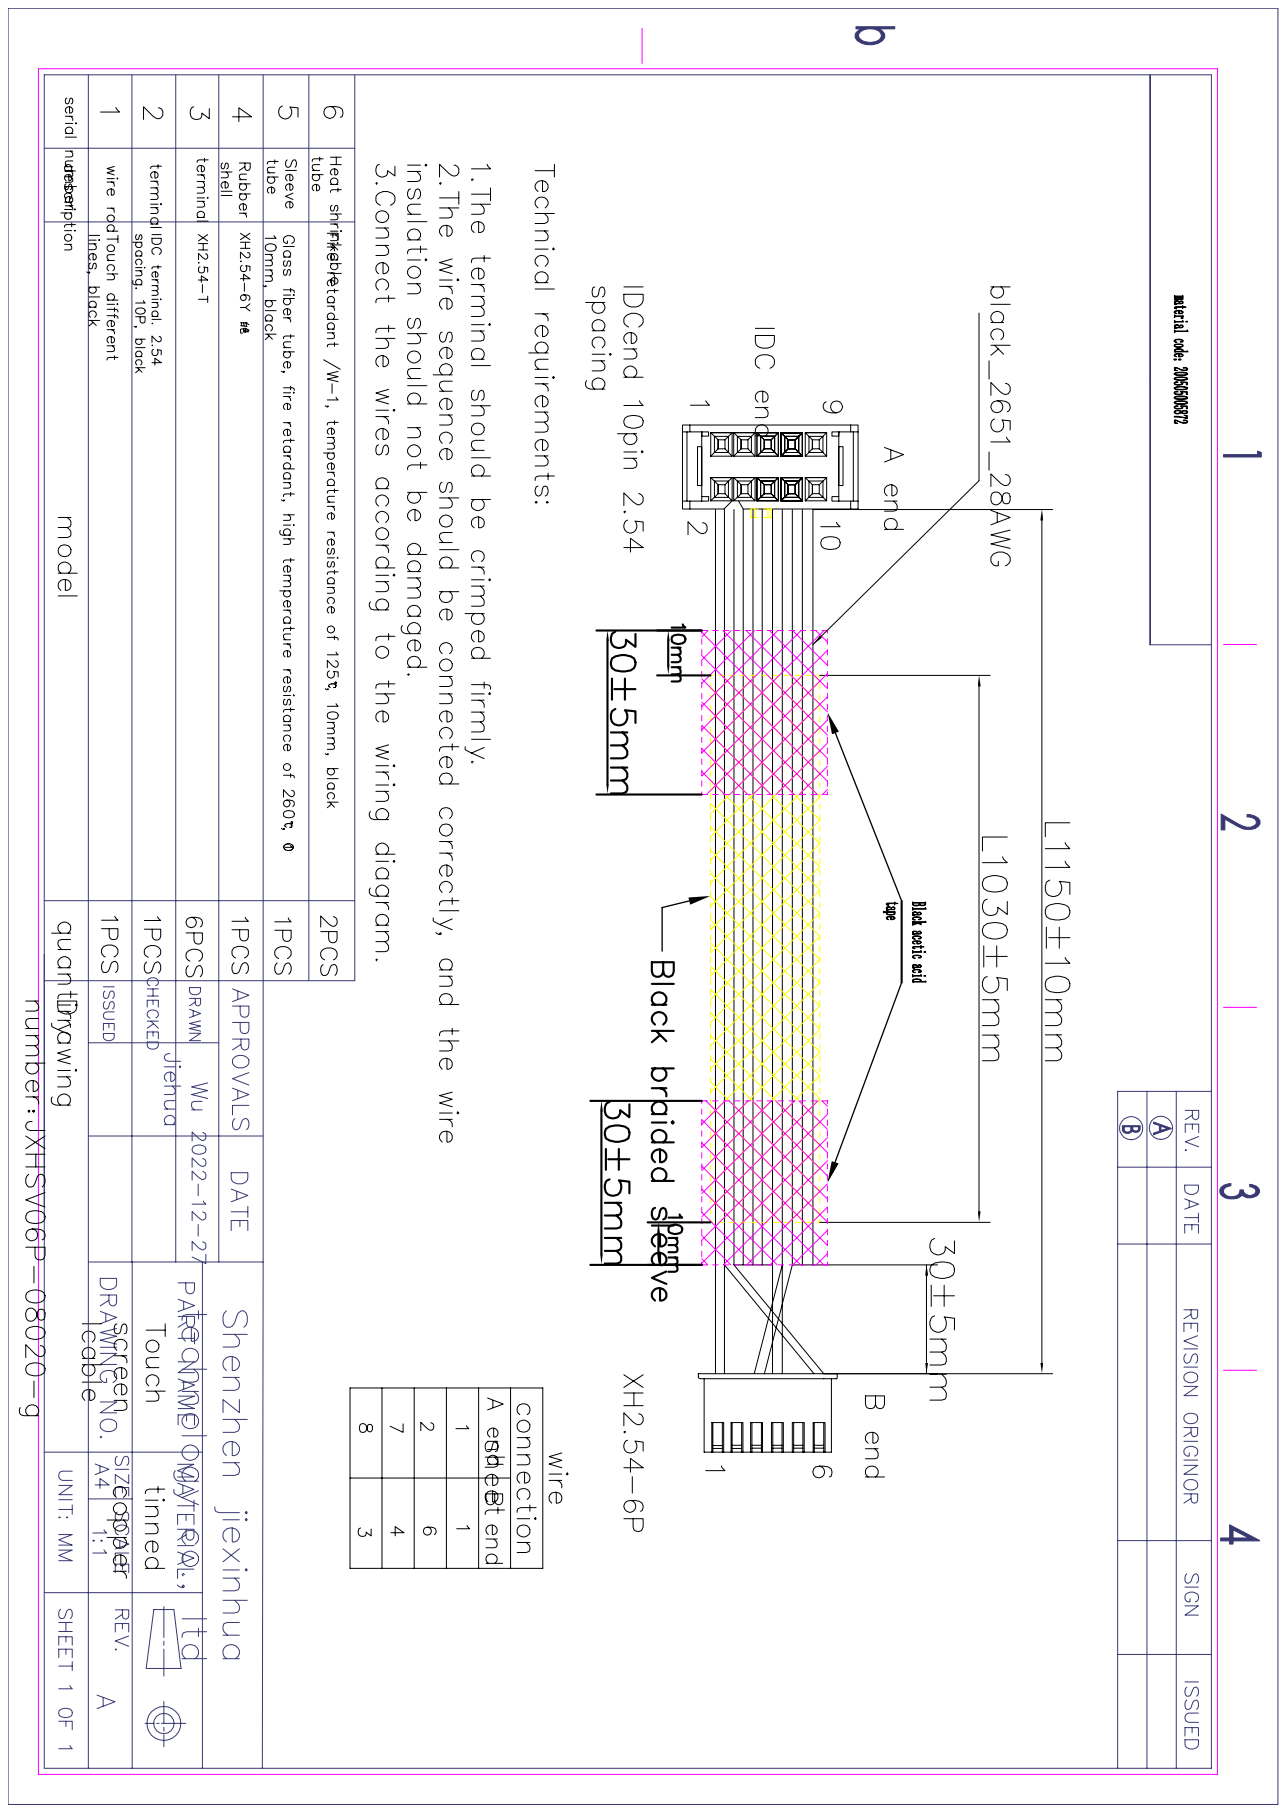
[picture p173: page 1]
