Sovol3d/SV06-PLUS/MarlinSV06Plus/Marlin/Configuration_adv.h

#define E0_AUTO_FAN_PIN -1
#define E1_AUTO_FAN_PIN -1
#define E2_AUTO_FAN_PIN -1
#define E3_AUTO_FAN_PIN -1
#define E4_AUTO_FAN_PIN -1
#define E5_AUTO_FAN_PIN -1
#define E6_AUTO_FAN_PIN -1
#define E7_AUTO_FAN_PIN -1
#define CHAMBER_AUTO_FAN_PIN -1
#define COOLER_AUTO_FAN_PIN -1
#define COOLER_FAN_PIN -1
#define HOMING_BUMP_MM      { 2, 2, 2 }       // (mm) Backoff from endstops after first bump
#define HOMING_BUMP_DIVISOR { 4, 4, 4 }       // Re-Bump Speed Divisor (Divides the Homing Feedrate)
#define MICROSTEP_MODES { 16, 16, 16, 16, 16, 16 } // [1,2,4,8,16]
#define LIN_ADVANCE
  #define LIN_ADVANCE_K 0.03    // Unit: mm compression per 1mm/s extruder speed
#define ADVANCED_PAUSE_FEATURE
  #define ADVANCED_PAUSE_PURGE_FEEDRATE        3  // (mm/s) Extrude feedrate (after loading). Should be slower than load feedrate.
  #define ADVANCED_PAUSE_PURGE_LENGTH         40  // (mm) Length to extrude after loading.
  #define ADVANCED_PAUSE_RESUME_PRIME          0  // (mm) Extra distance to prime nozzle after returning from park.
    #define X_CURRENT       820        // (mA) RMS current. Multiply by 1.414 for peak current.
    #define X_CURRENT_HOME  X_CURRENT  // (mA) RMS current for sensorless homing
    #define X_MICROSTEPS     16        // 0..256
    #define Y_CURRENT       880
    #define Y_CURRENT_HOME  Y_CURRENT
    #define Y_MICROSTEPS     16
    #define Z_CURRENT       800
    #define Z_CURRENT_HOME  Z_CURRENT
    #define Z_MICROSTEPS     16
    #define E0_CURRENT      550
    #define E0_MICROSTEPS    16
    #define CURRENT_STEP_DOWN     50  // [mA]
    #define REPORT_CURRENT_CHANGE
  #define HYBRID_THRESHOLD
  #define X_HYBRID_THRESHOLD     250  // [mm/s]
  #define X2_HYBRID_THRESHOLD    180
  #define Y_HYBRID_THRESHOLD     250
  #define Y2_HYBRID_THRESHOLD    180
  #define Z_HYBRID_THRESHOLD      60
  #define Z2_HYBRID_THRESHOLD      3
  #define Z3_HYBRID_THRESHOLD      3
  #define Z4_HYBRID_THRESHOLD      3
  #define I_HYBRID_THRESHOLD       3
  #define J_HYBRID_THRESHOLD       3
  #define K_HYBRID_THRESHOLD       3
  #define E0_HYBRID_THRESHOLD     80
  #define E1_HYBRID_THRESHOLD     30
  #define E2_HYBRID_THRESHOLD     30
  #define E3_HYBRID_THRESHOLD     30
  #define E4_HYBRID_THRESHOLD     30
  #define E5_HYBRID_THRESHOLD     30
  #define E6_HYBRID_THRESHOLD     30
  #define E7_HYBRID_THRESHOLD     30
  #define SENSORLESS_HOMING // StallGuard capable drivers only
    #define X_STALL_SENSITIVITY  86
    #define X2_STALL_SENSITIVITY X_STALL_SENSITIVITY
    #define Y_STALL_SENSITIVITY  110
    #define Y2_STALL_SENSITIVITY Y_STALL_SENSITIVITY
  #define GANTRY_CALIBRATION_CURRENT          850     // Default calibration current in ma
