Sovol3d/SV06-PLUS/(commit log)

2023-06-09 Add machine drawing
    [JXHSV06-01007-d Base Belt Buckle.step, JXHSV06-01009-d Hot Bed Wire Fixing Cover.step, JXHSV06-01010-d Large Tensioner Knob.step, JXHSV06-01011-d Base Tensioner Mount.step, JXHSV06-01017-d Base Tensioner Fixing Piece.step, JXHSV06-01019-d Wire Clip.step, JXHSV06-03002-d X-axis motor mounting seat.step, JXHSV06-03005-d X-axis tensioning wheel mounting seat.step]
2023-06-10 Add STL file
    [JXHSV06-01007-d Base Belt Buckle.step, JXHSV06-01009-d Hot Bed Wire Fixing Cover.step, JXHSV06-01010-d Large Tensioner Knob.step, JXHSV06-01011-d Base Tensioner Mount.step, JXHSV06-01017-d Base Tensioner Fixing Piece.step, JXHSV06-01019-d Wire Clip.step, JXHSV06-03002-d X-axis motor mounting seat.step, JXHSV06-03005-d X-axis tensioning wheel mounting seat.step]
